Demitryk/Voron2.4-Mods/README.md

# Voron2.4-Mods
My personal Voron 2.4 Mods
