Demitryk/Voron2.4-Mods/Electronics_Brackets/README.md

# Electronics Brackets #

These are all designed to be used with SSR brackets. They all require heated inserts.
  
Brackets:  
  - Pi with 25mm fan holder
  - Octopus Pro with 40 mm fan holder
  - MKS PWC v3 Bracket
  - Meanwell 24V PS Bracket (to mount across 2 DIN rails) NOTE Spacing may differ from mine.

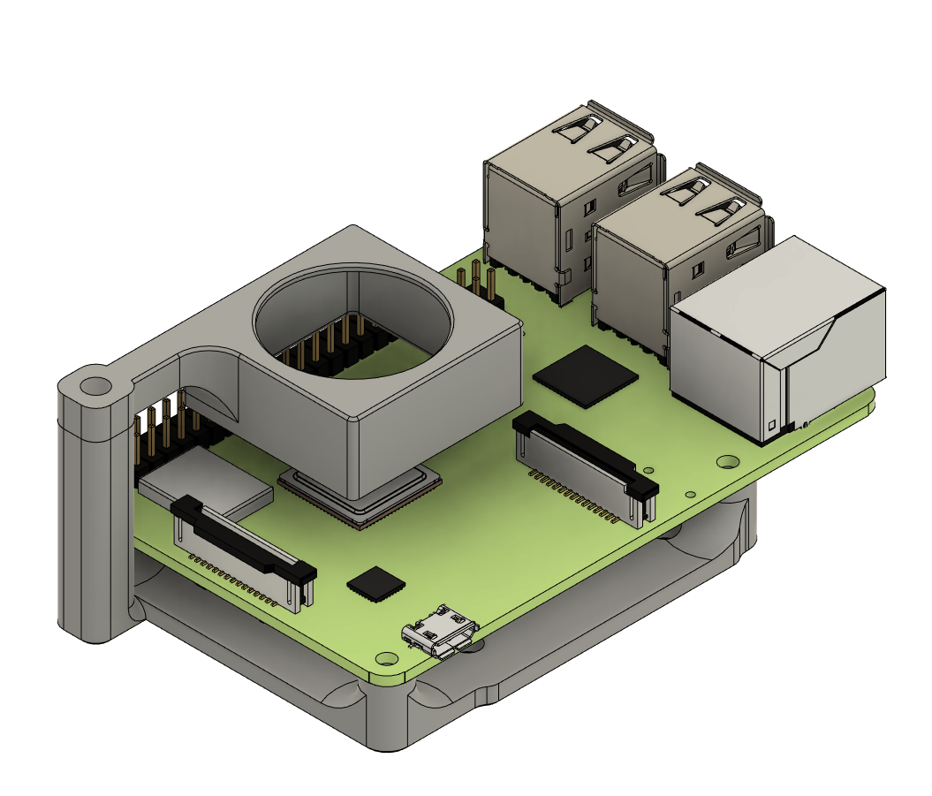
[picture p1: Electronics_Brackets/Images/pi.PNG]
 
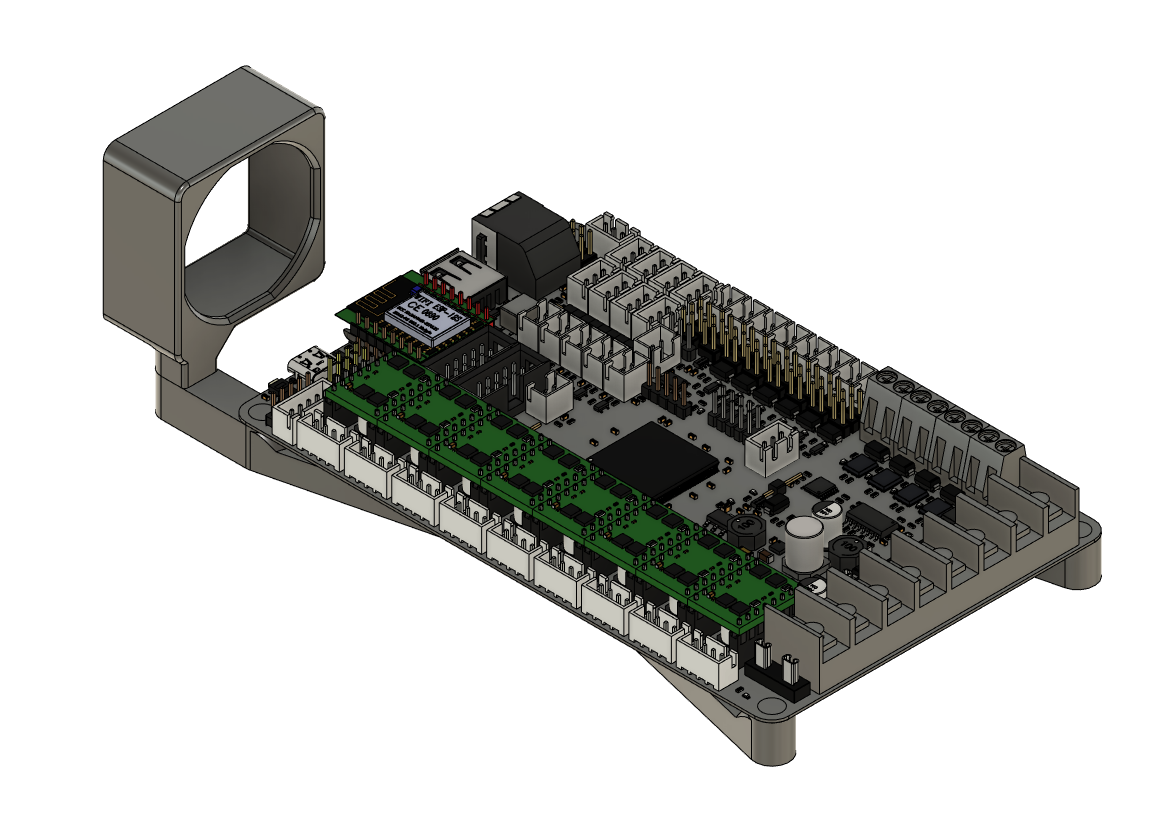
[picture p2: Electronics_Brackets/Images/Octo.PNG]
 
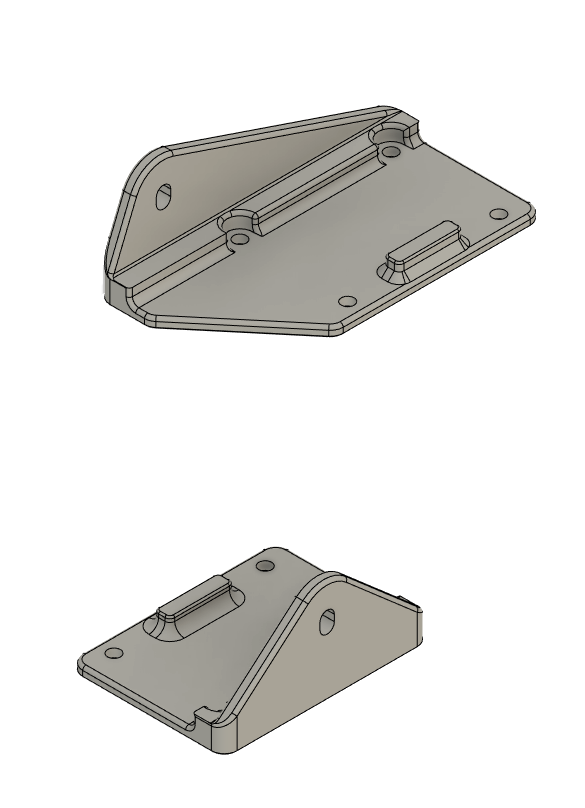
[picture p3: Electronics_Brackets/Images/24V.PNG]
 
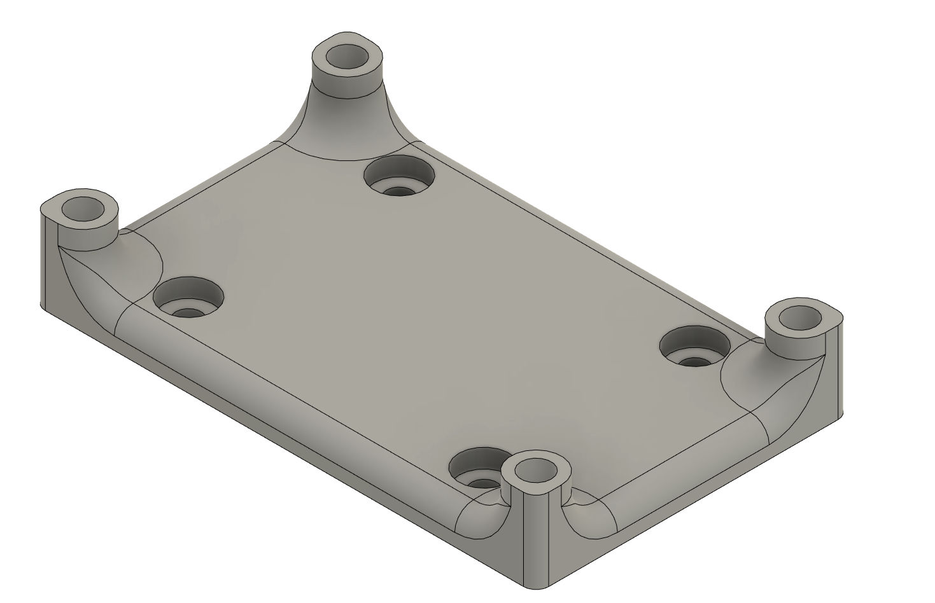
[picture p4: Electronics_Brackets/Images/PWC.PNG]
