Demitryk/Voron2.4-Mods/Bed_Frame_Backlit_Logo/README.md

# Bed Frame Backlit Logo #  

Another Backlit detail for the Voron. This will fit as shown if your bed supports are the distance directed in the BOM (130mm).

### What You Need ###  
---Printed Pieces  
- Main Body x1 - Any Color  
- Clear Body x1 - Clear  
- O Center x2 - Any Color  
- R Center x1 - Any Color  
- Lid x1 - Any Color  

---Hardware  
- 2 x M3 Threaded Inserts   
- 2 x M3 8mm Socket Screws  
- 2 x M5 8mm Screws
- COB LEDs  
- Super Glue 

Here’s is a link to the ones i used:    
https://www.amazon.com/gp/product/B08M9MSH77/ref=ppx_yo_dt_b_asin_title_o04_s07?ie=UTF8&th=1

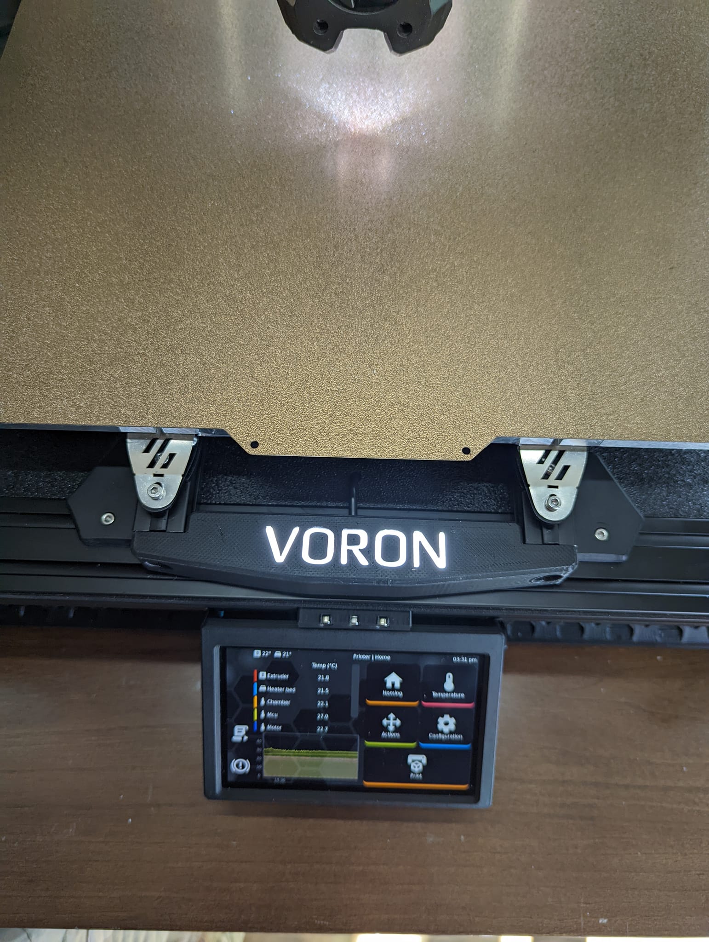
[picture p5: Bed_Frame_Backlit_Logo/Images/actual.jpg]
 
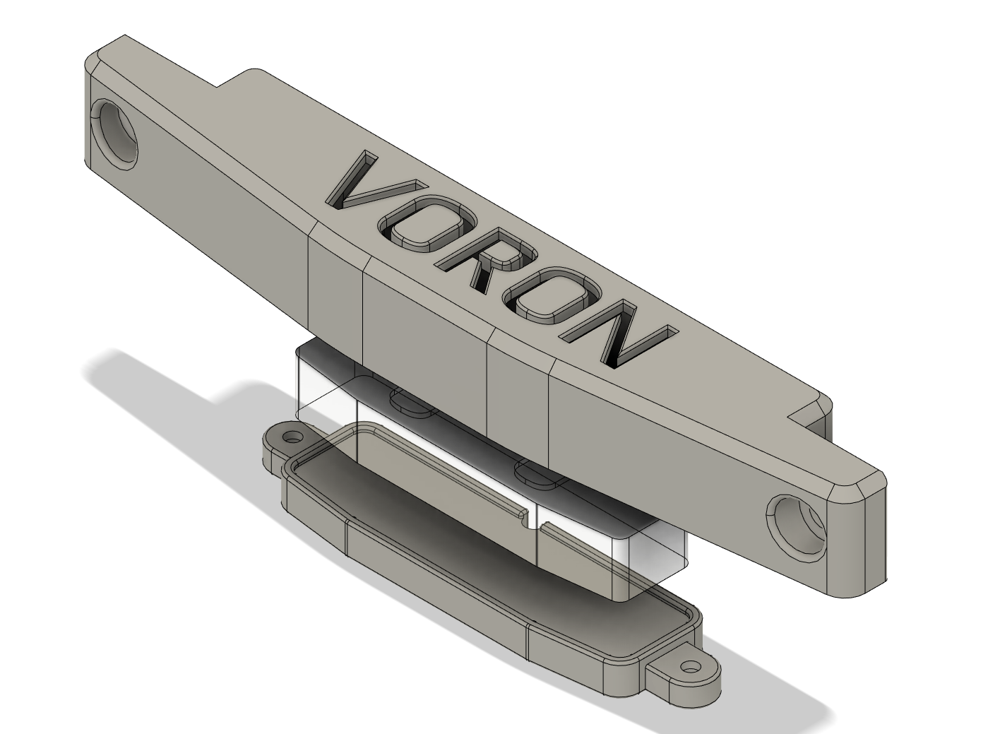
[picture p6: Bed_Frame_Backlit_Logo/Images/Break down.PNG]
 
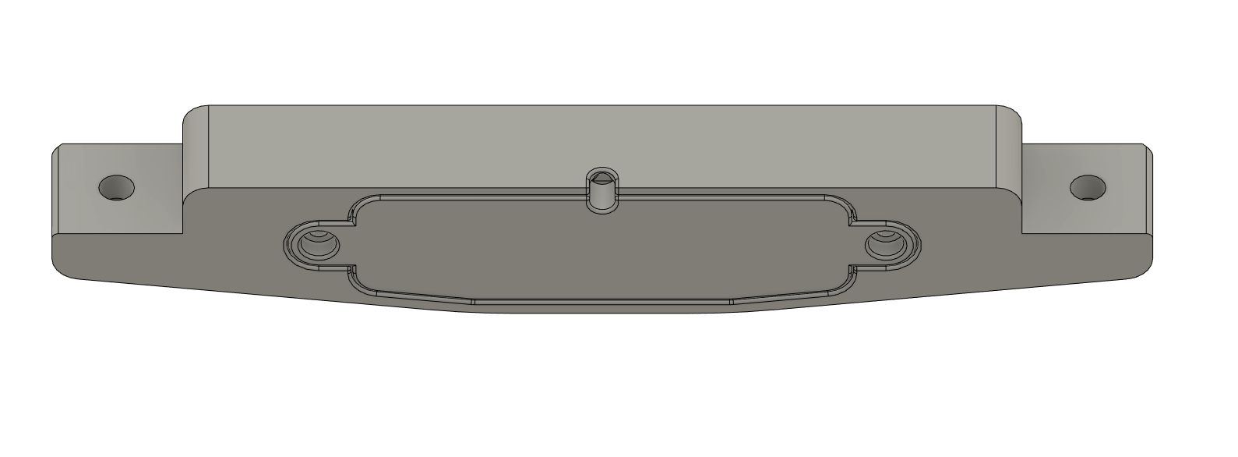
[picture p7: Bed_Frame_Backlit_Logo/Images/Bottom.PNG]
 

___________________________________________________________________________________________________________________________________________
### Installation ###  

---Threaded Inserts and LEDs  
The 2 threaded m3 inserts are placed in the holes in the main body. LEDs should be routed as shown in red. I would solder the wire to the LEDs before routing

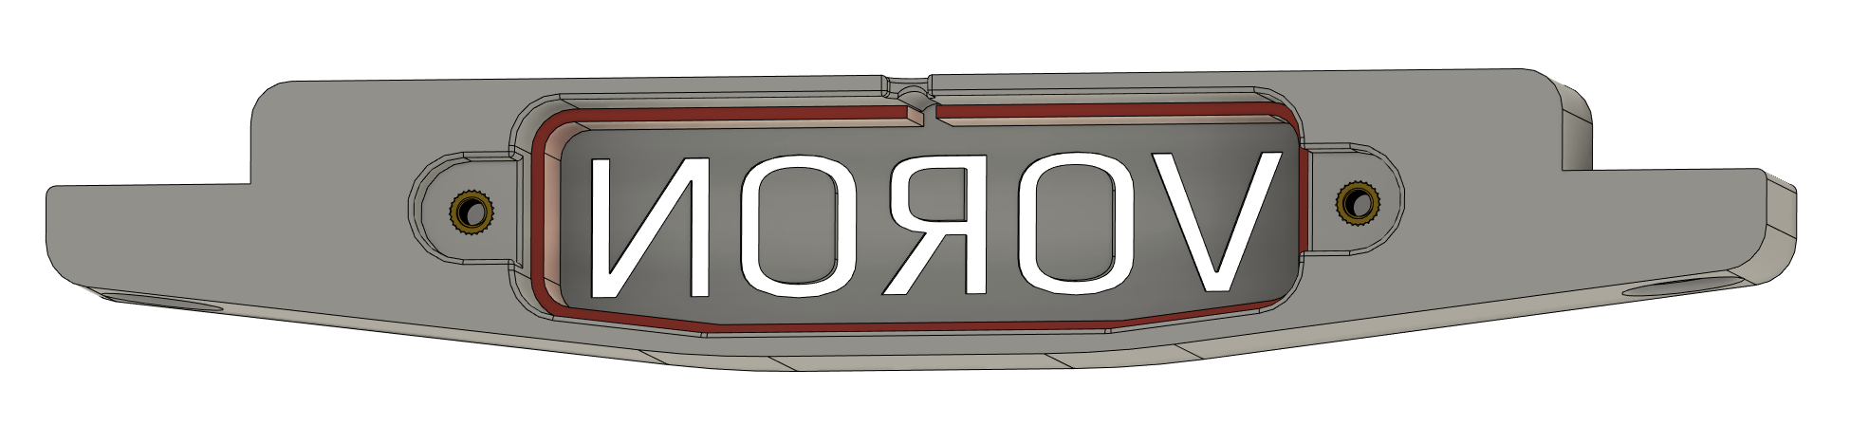
[picture p8: Bed_Frame_Backlit_Logo/Images/LED.PNG]
  

--- Instructions  
- Print pieces   
- Install threaded inserts  
- Install LEDs routing the wire trough the hole  
- Put everything together and install screws
- Glue and center the O and R Centers inplace  
- Install on the frame ends  
- Wire to power source
