Demitryk/Voron2.4-Mods/Backlit_Logo/README.md

# Backlit Voron Logo #  
  
***This logo is 12mm thick. will not fit in on a standard framed Voron back panel ... 4040/4020 frame only***  
  
Another option for the back deck artwork. This requires you to drill 6 holes in the back panel using the drill hole guide.

### What You Need ###  
---Printed Pieces  
- Logo Frame x1 - Any Color  
- Logo Middle x1 - Clear  
- Logo Side x2 - Clear  
- Outer Ring x1 - Clear  
  
for clear printed pieces I used a honeycomb infill with 4 top layers to obtain that hexagon effect. i printed them top side down so they were smooth because when using so little infill the tops arent as pretty. I used sunlu clear petg.   

---Hardware  
- 5 x M3 Threaded Inserts   
- 5 x M3 8mm Socket Screws  
- Foam tape
- COB LEDs   
  
NOTE: LEDs strips cannot be more that 9mm tall or 2mm thick. I designed this to be used with COB LEDs.  These give a continuous strip of light. They do come in 12V, 24V, and 5V addressable RGB. i used 6000K white.

Here’s is a link to the ones i used, they say they are 10 mm tall but were actually 8mm:   
https://www.amazon.com/gp/product/B08M9MSH77/ref=ppx_yo_dt_b_asin_title_o04_s07?ie=UTF8&th=1

 
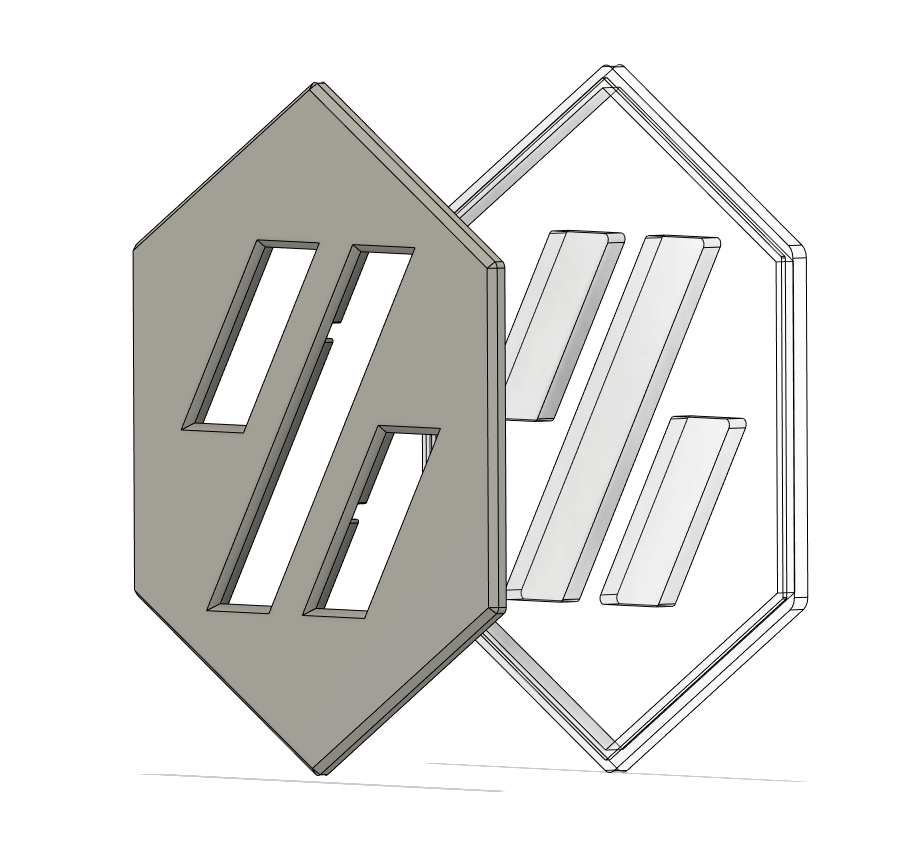
[picture p19: Backlit_Logo/Images/Exploded.PNG]
 
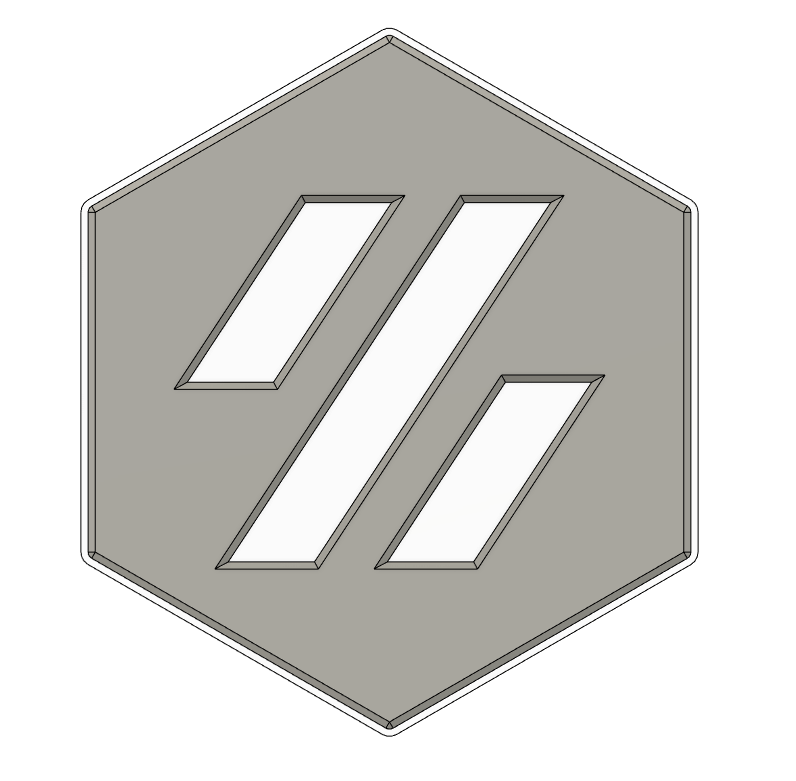
[picture p20: Backlit_Logo/Images/Front.PNG]
 
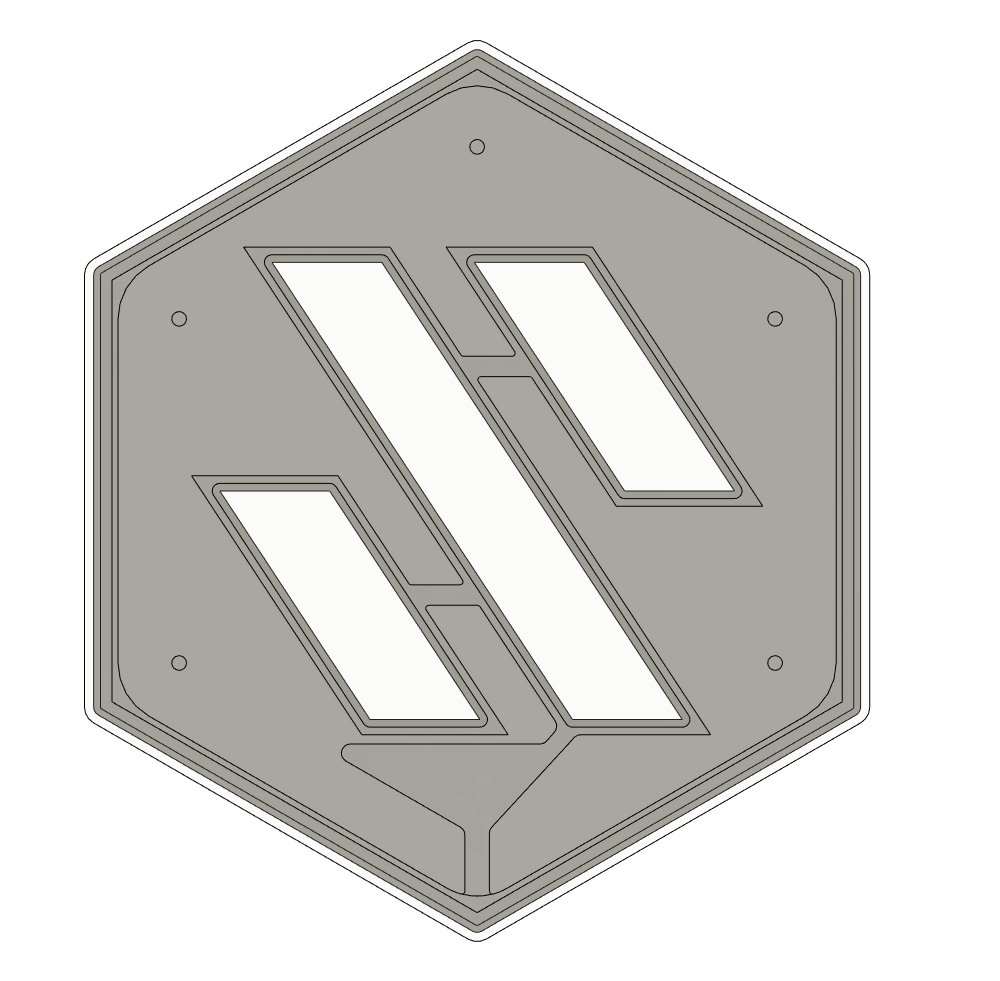
[picture p21: Backlit_Logo/Images/Rear.PNG]
 
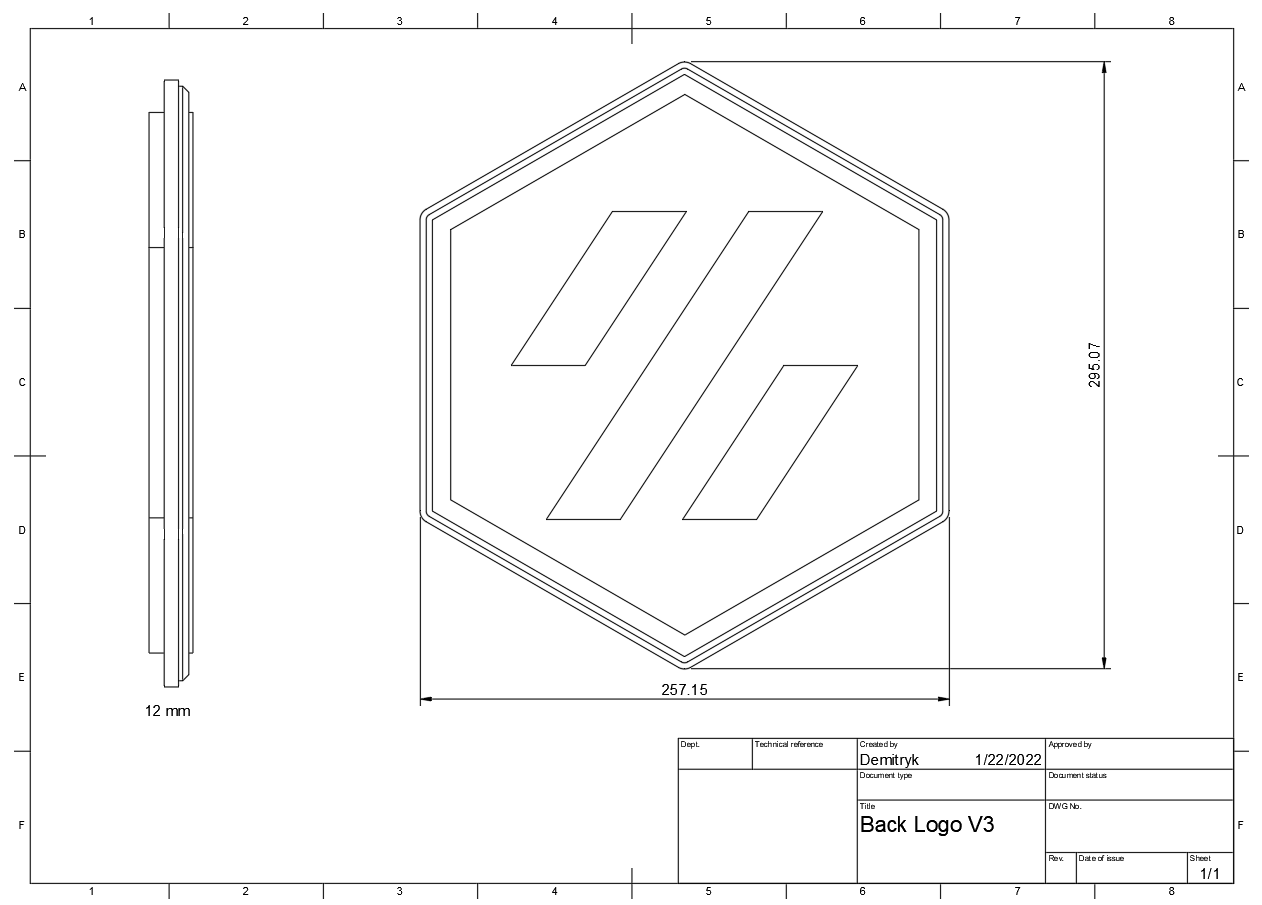
[picture p22: Backlit_Logo/Images/Size.PNG]
 

___________________________________________________________________________________________________________________________________________
### Installation ###  

---Threaded Inserts and LEDs  
The 5 threaded m3 inserts are placed as shown. LEDs should be routed as shown in red. I would solder the wire to the LEDs before routing 

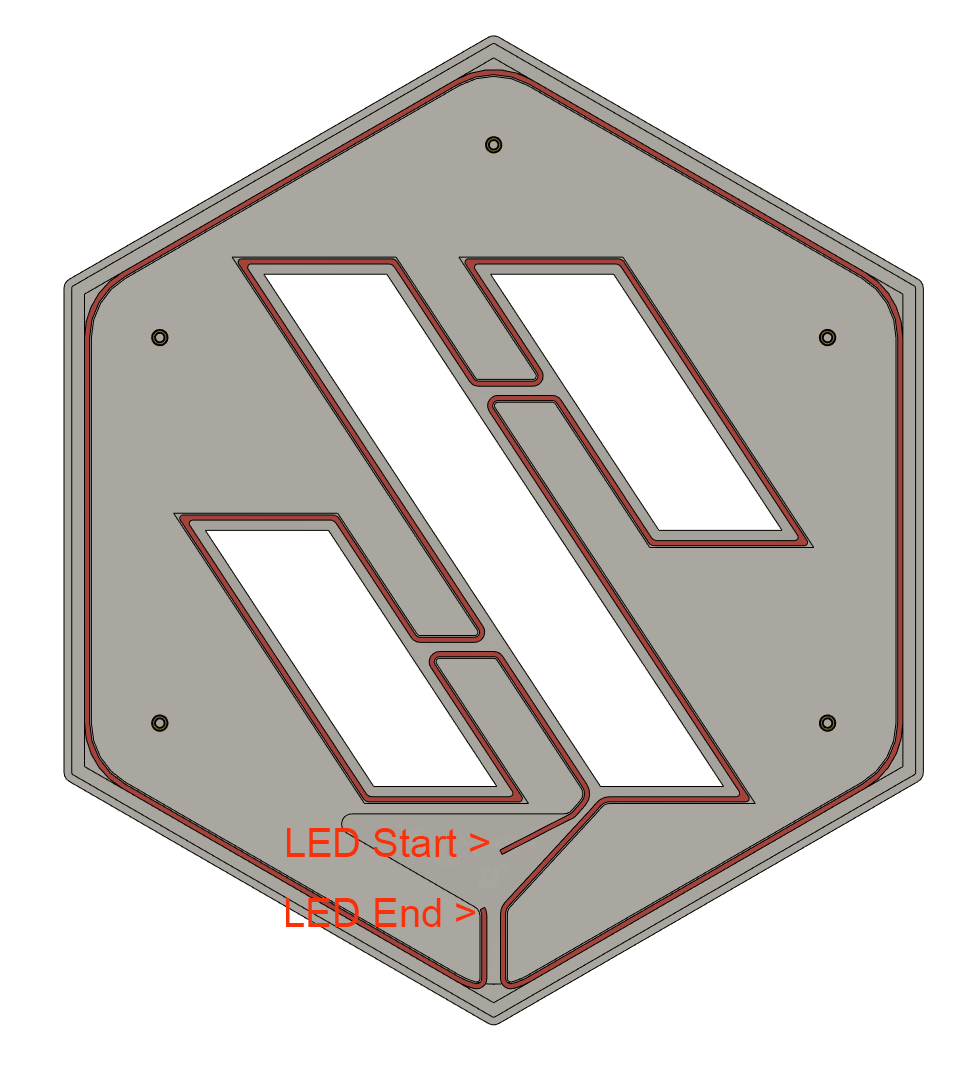
[picture p23: Backlit_Logo/Images/Install.PNG]
  

--- Instructions  
- Print pieces   
- Install threaded inserts  
- Install LEDs  
- Center the drill hole guide on the back panel and drill the 6 holes. The bottom hole is to route the wire though the back.  
- Place foam tape on the back side of the outer ring and on the back side of the logo pieces. this will force them to be squished and keep pieces from rattling  
- install the screws, they should go through the back panel into the Logo frame
