Demitryk/Voron2.4-Mods/BTT_PiTFT5_Screen_Mount/README.md

# BTT PiTFT5 v2 Screen Mount  #
This is a screen mount for the BTT PiTFT5 v2. It is a fixed angle and has a bezel to cover the edges of the screen. The bezel still allows access to the black light wheel and the inversion switch. You have two options in frame mounts.

### What You Need ###  
----printed pieces  
- Bezel.stl  
- Back.stl  
- Sttts frame Mount.stl (30 degree angle) or Table Clearence Frame Mount.stl (52 degree angle) 

*NOTE: I did not create the Sttts frame mount, this was designed by sttts. here is the link to the original Frame mount. https://github.com/VoronDesign/VoronUsers/blob/master/printer_mods/sttts/Waveshare-5.5-inch-HDMI-AMOLED/STLs/Voron-2.4-Mount-Generisch-v6.stl* 

----Hardware  
- Big Tree Tech PiTFT5 v5 and the screws it came with  
- Longer 15 pin Display Cable  
- 6 x M3 Threaded Inserts  
- 2 x M3 Flat Head Countersunk Screws  
- 4 x M3 6mm Socket Screws  
- 3 x M3 10mm Socket Screws  
- 3 x M3 Frame Nuts  

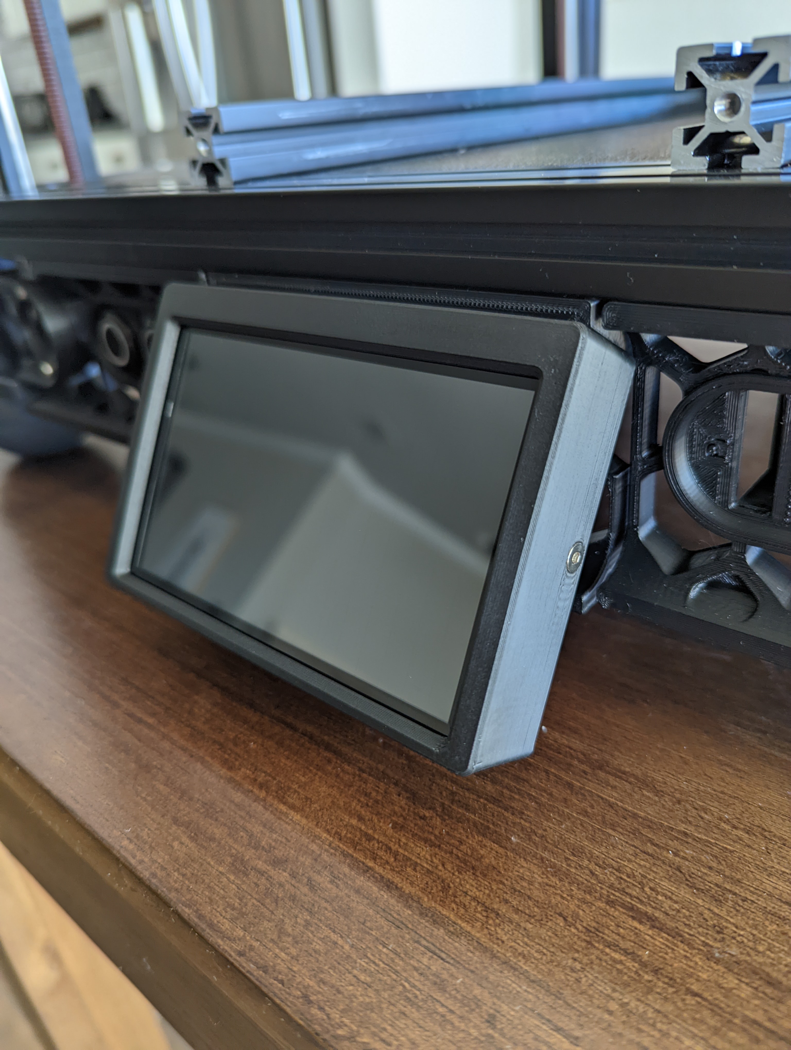
[picture p24: BTT_PiTFT5_Screen_Mount/Images/Actual.jpg]
 
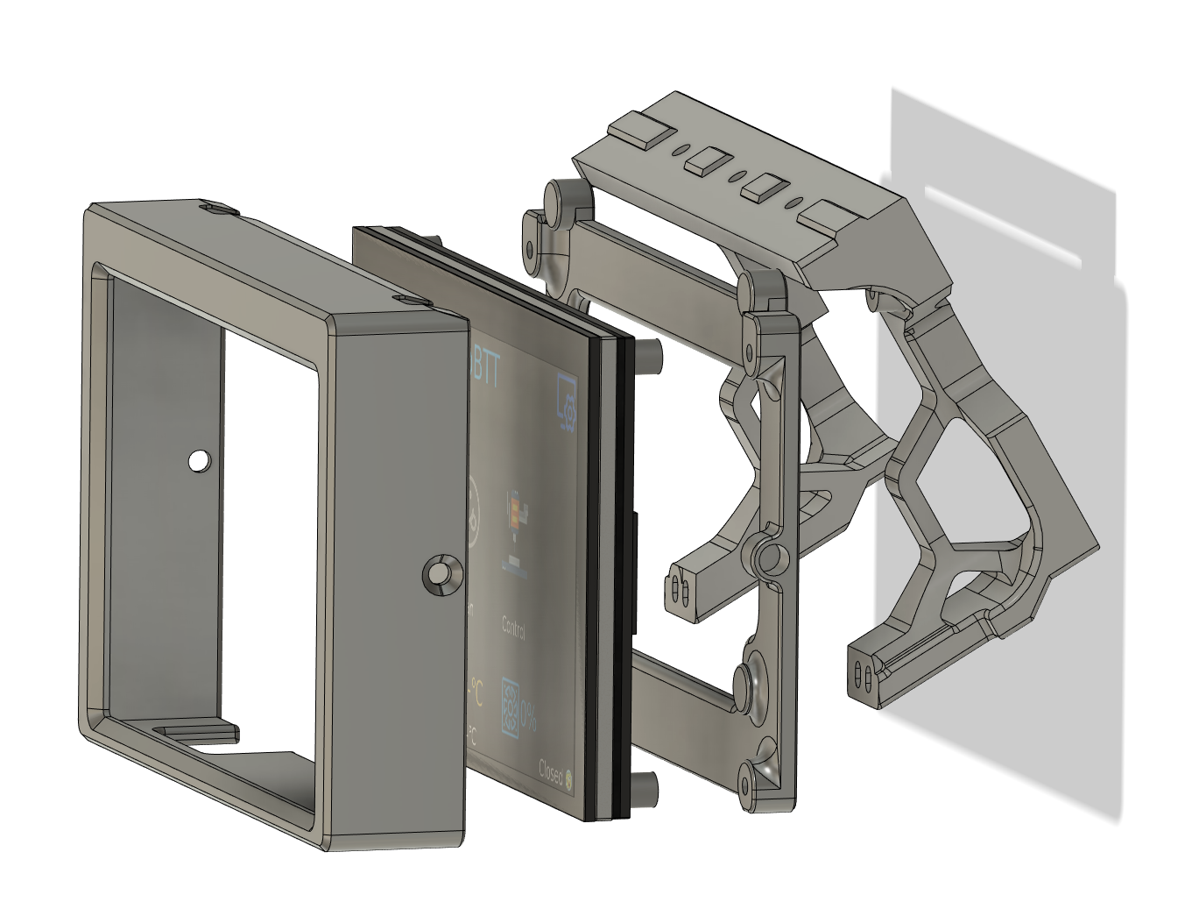
[picture p25: BTT_PiTFT5_Screen_Mount/Images/Exploded.PNG]
 
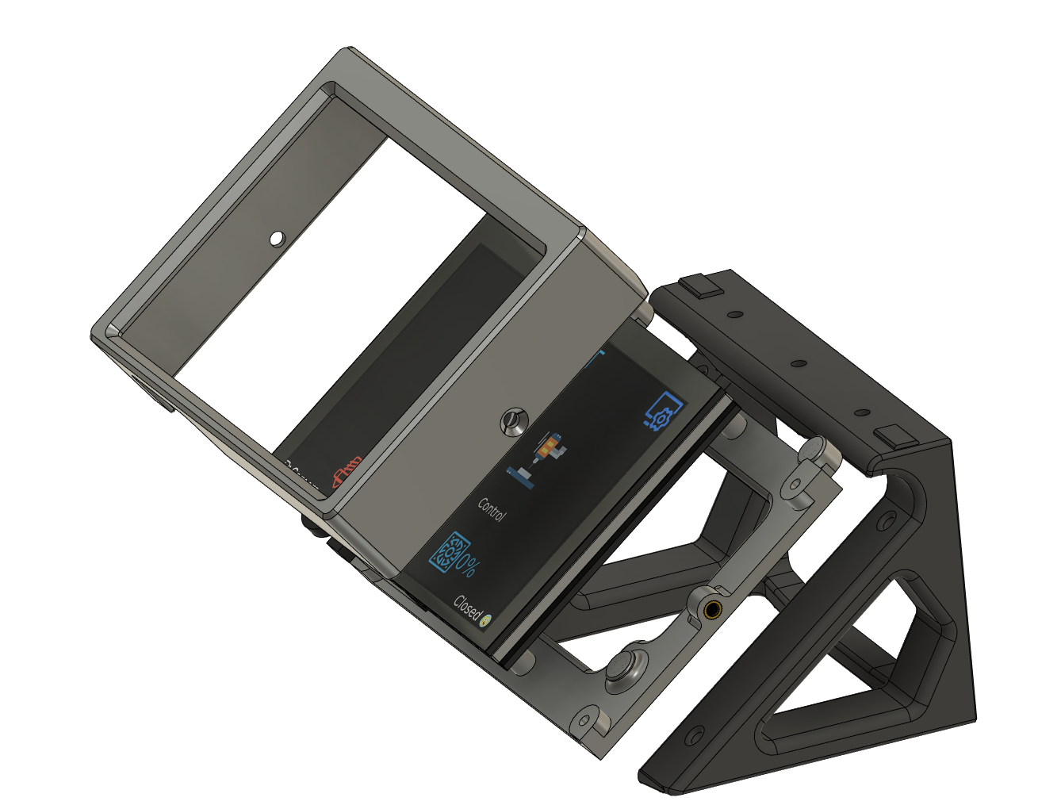
[picture p26: BTT_PiTFT5_Screen_Mount/Images/Explode2.PNG]

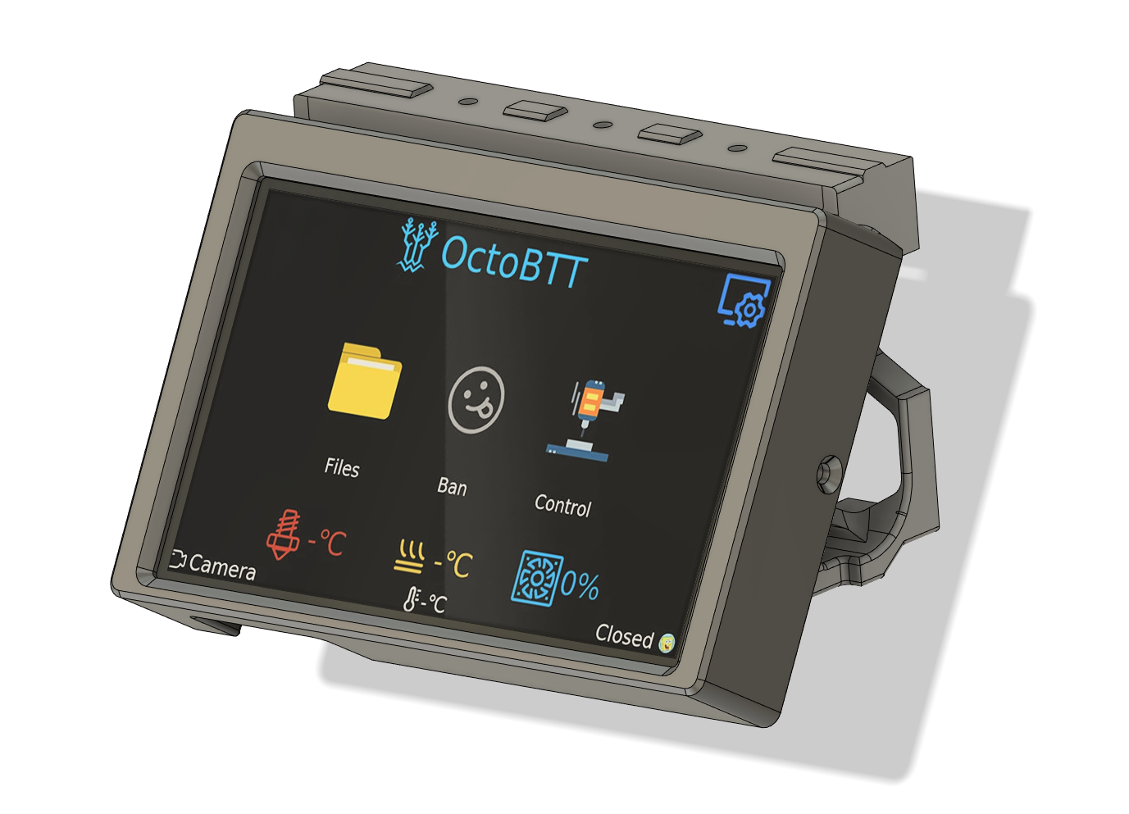
[picture p27: BTT_PiTFT5_Screen_Mount/Images/Angl.PNG]

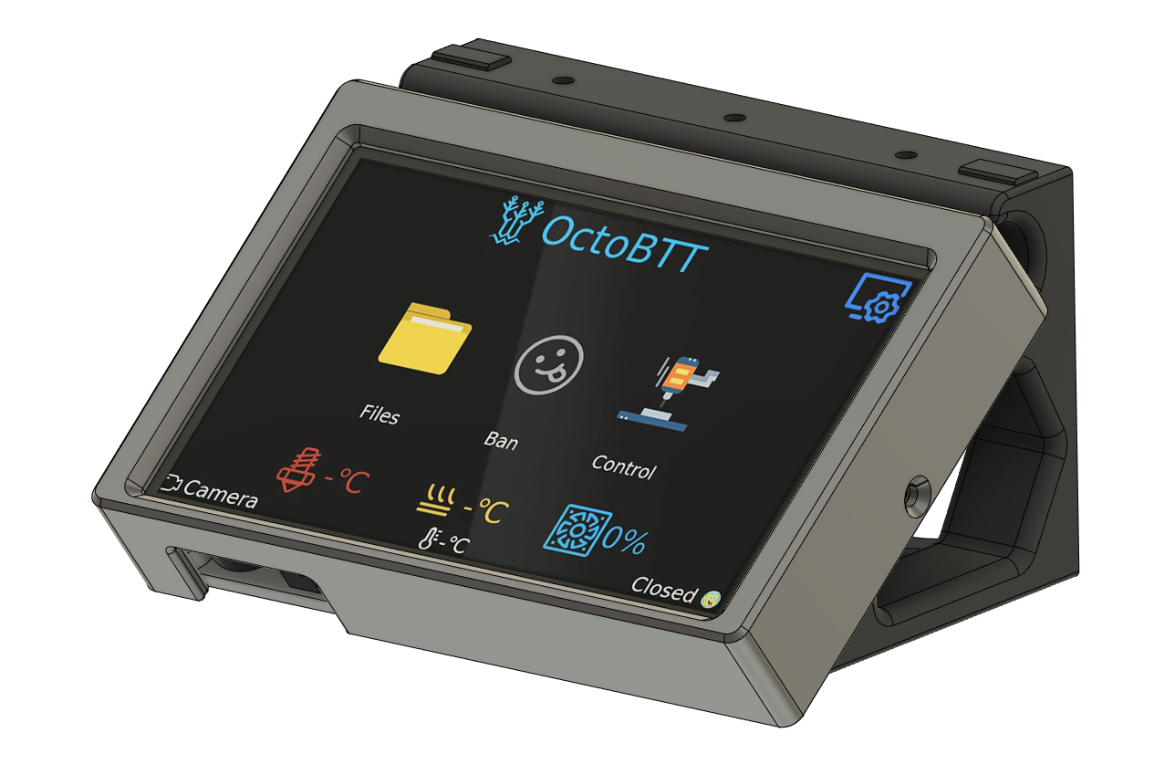
[picture p28: BTT_PiTFT5_Screen_Mount/Images/Angle2.PNG]
 
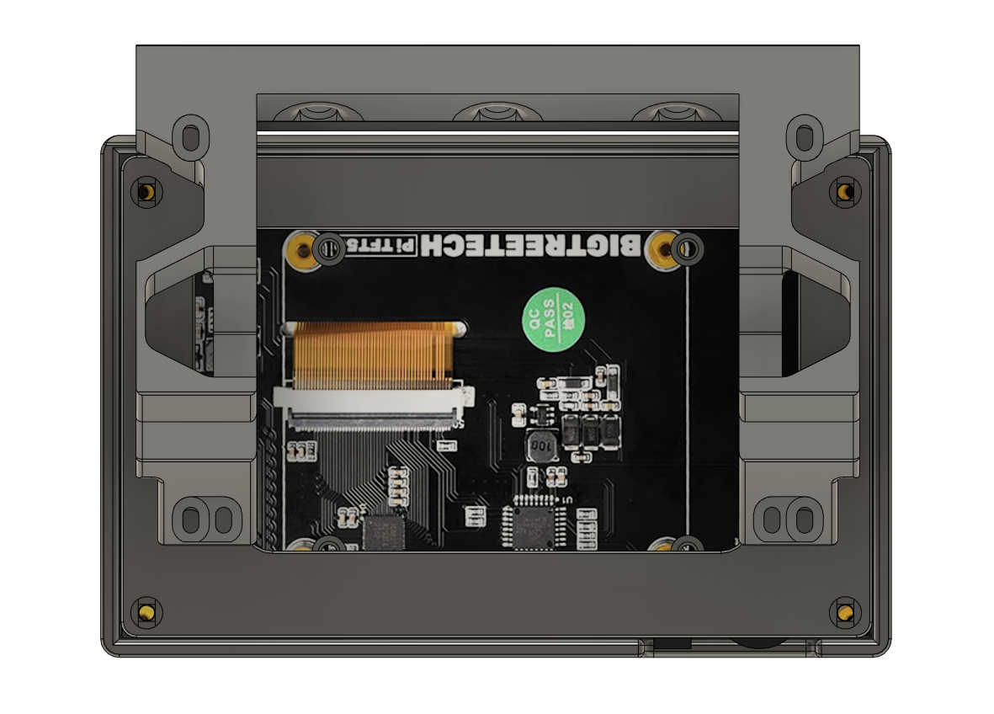
[picture p29: BTT_PiTFT5_Screen_Mount/Images/Bottom.PNG]
 
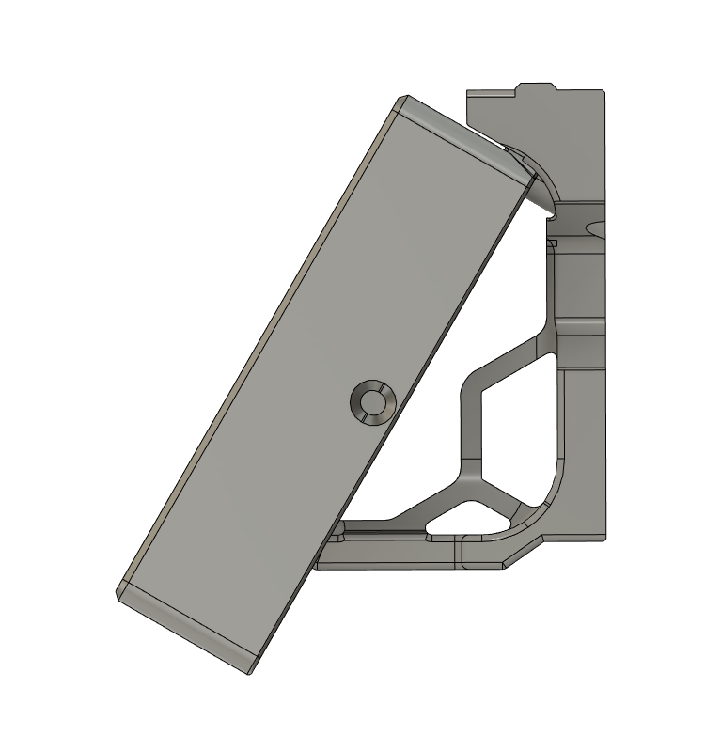
[picture p30: BTT_PiTFT5_Screen_Mount/Images/Side.PNG]
 
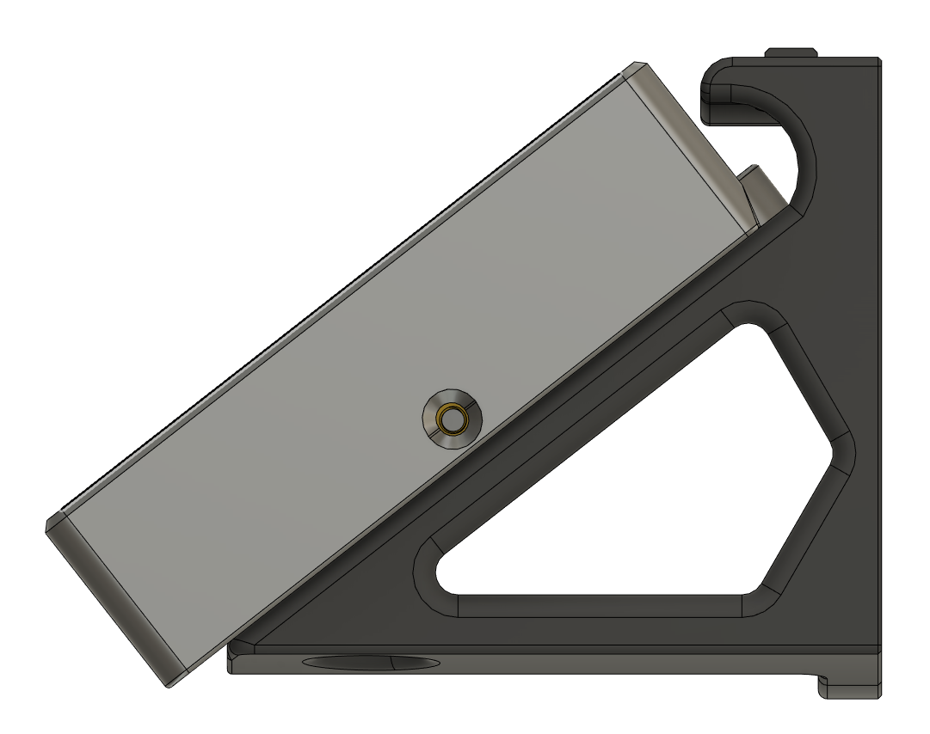
[picture p31: BTT_PiTFT5_Screen_Mount/Images/Side2.PNG]
 

___________________________________________________________________________________________________________________________________________
### Installation ###  

---Threaded Inserts  
The six threaded m3 inserts are placed as shown. There is one more on the other side.  

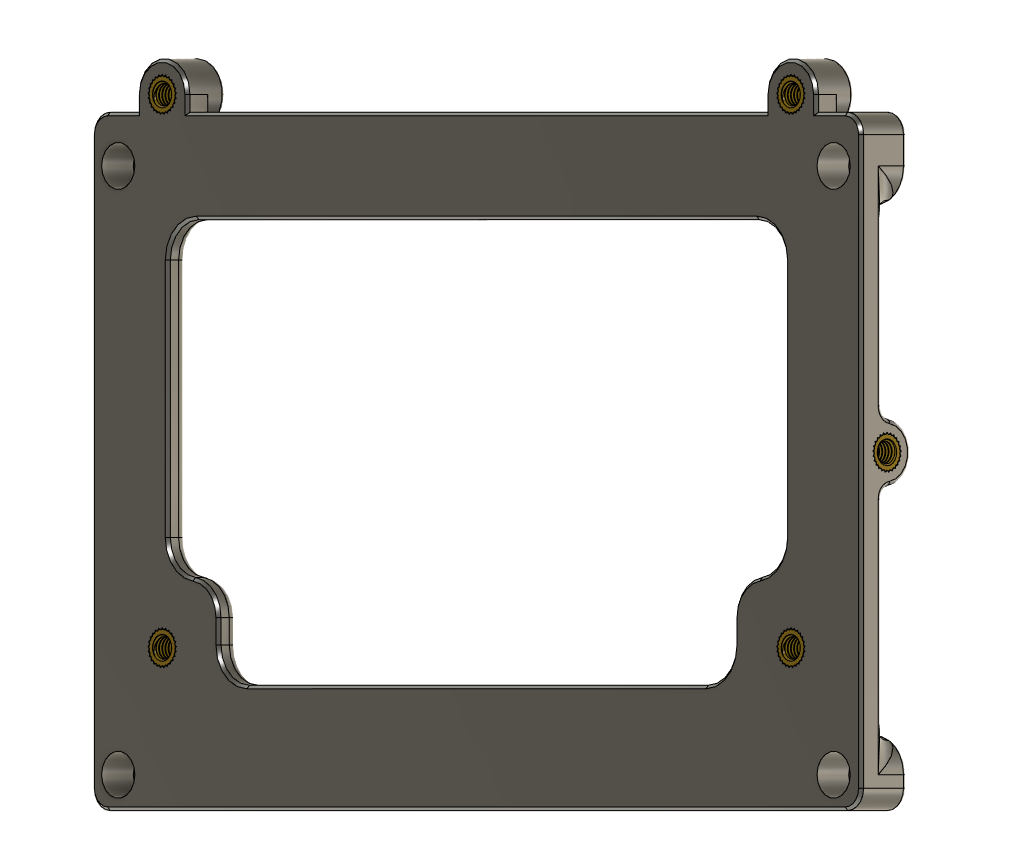
[picture p32: BTT_PiTFT5_Screen_Mount/Images/Threded.PNG]
  

--- Instructions  
- Install display cable to the screen (may have to put a 90 bend in the cable end)
- Use 4 of the screws that came with the screen to attach the screen to the back stl. The back light wheel and switch to be toward the bottom  
- Route the cable behind the screen and though the opening in the back  
- Attach the back stl to the frame mount using the 4 M3 6mm screws  
- Attach the frame mount to the frame using the 3 M3 10mm screws and frame nuts  
- Install the bezel over the screen and secure using the 2 M3 Flat Head Countersunk Screws
