Demitryk/Voron2.4-Mods/Z_Belt_Cover_&_Deck_Clamps/README.md

# Z Belt Cover & Deck Clamps  #  
  
***These will not fit in on a standard framed Voron ... 4040/4020 frame only***  
  
These are just some Z Belt covers and Deck claps I created. The Z belt clamps have a groove that allow you to pass wires from the adjacent vertical V slot to the electronics compartment.

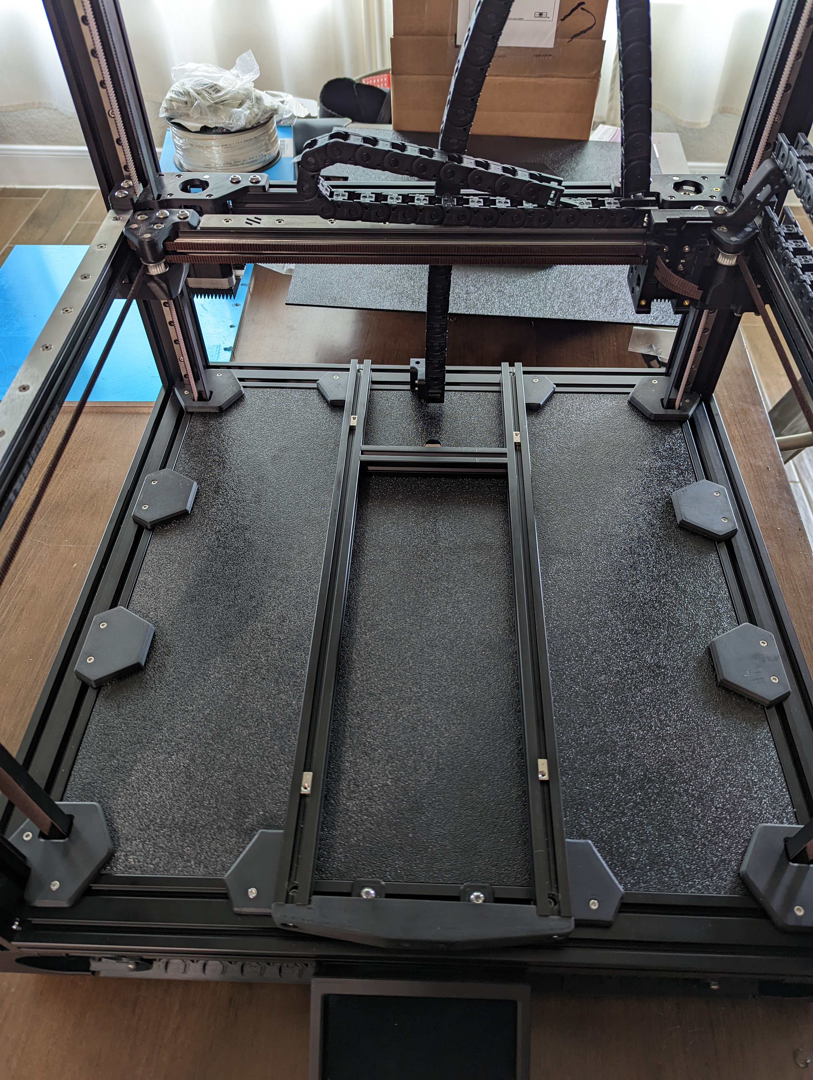
[picture p33: Z_Belt_Cover_&_Deck_Clamps/Images/Actual.jpg]
 
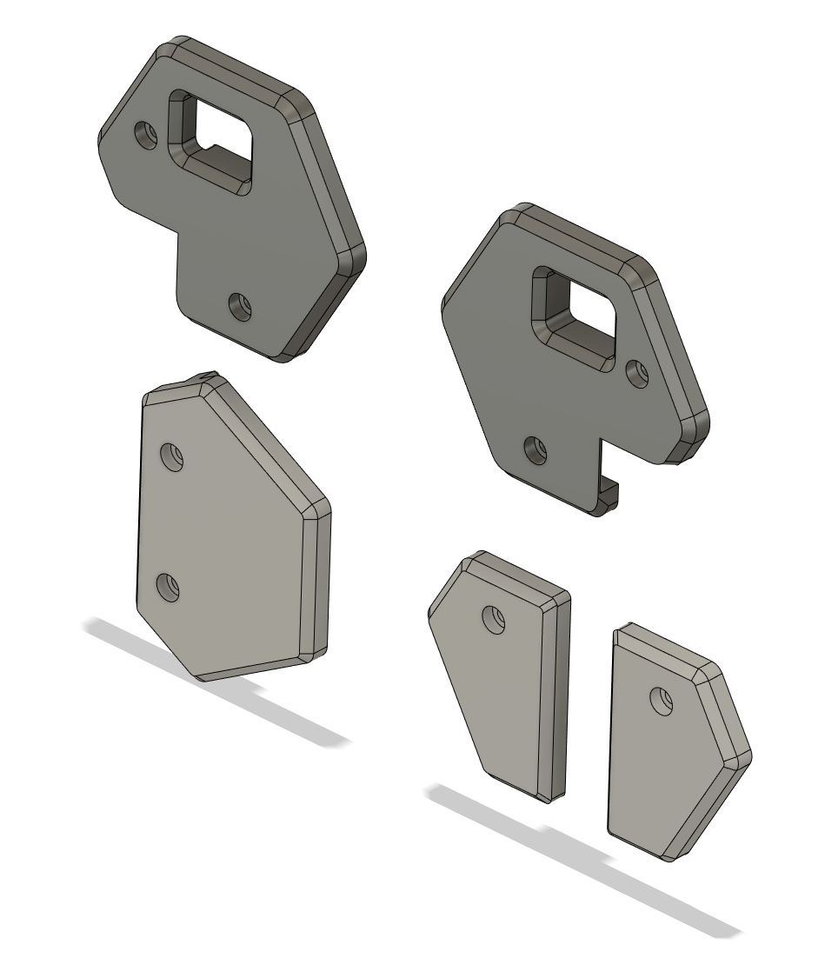
[picture p34: Z_Belt_Cover_&_Deck_Clamps/Images/Angle.PNG]
 
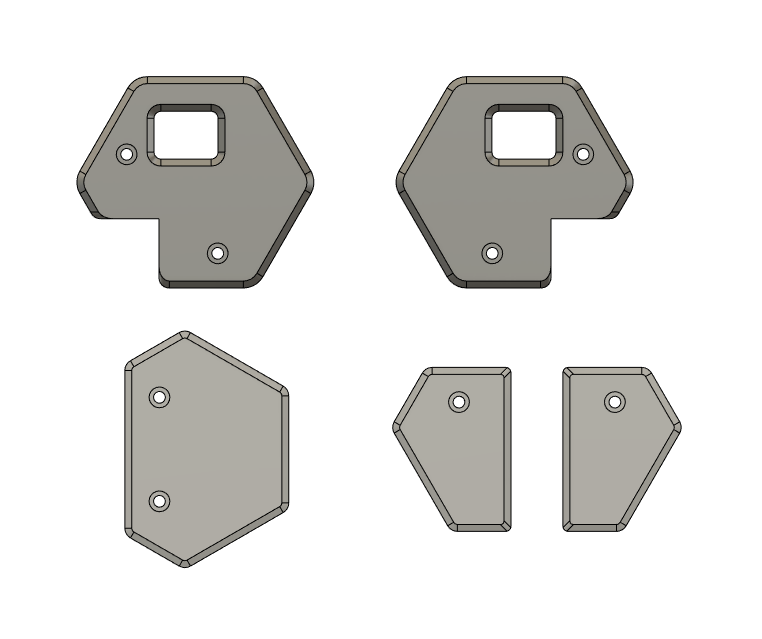
[picture p35: Z_Belt_Cover_&_Deck_Clamps/Images/Front.PNG]
 
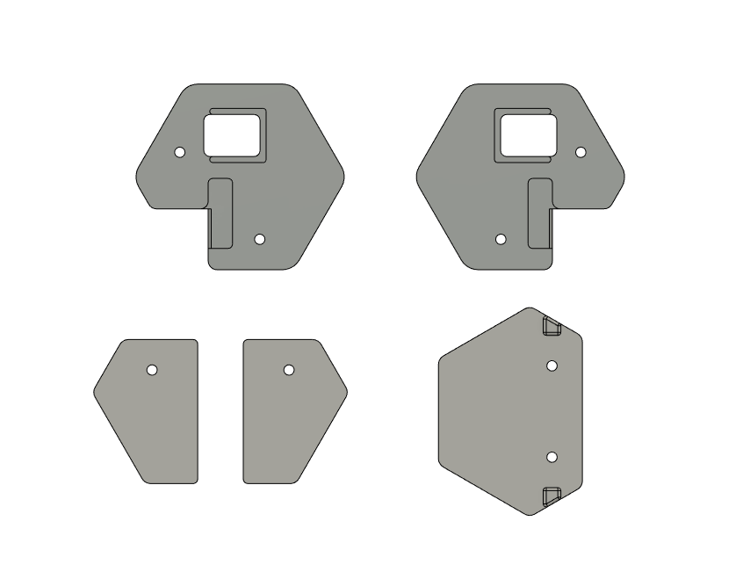
[picture p36: Z_Belt_Cover_&_Deck_Clamps/Images/Rear.PNG]
