Demitryk/Voron2.4-Mods/Skirt_Buttons/README.md

# Skirt Button Mod - For 350mm Version Only  #
These are the front skirts that I modified to install buttons. In the left skirt, there are 3 x 19mm holes that allow the installation of switches. The right skirt contains 2 slots for micro-SD card extenders (for the Pi and control board) and 1 hole of and aviation style connector (16mm). I planned on using the aviation connector for the ADXL345 connection to the Pi. 

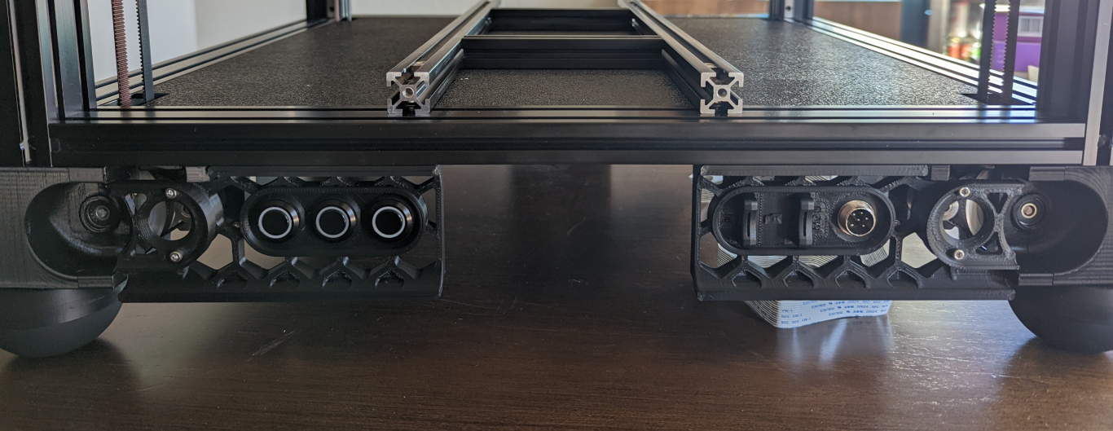
[picture p37: Skirt_Buttons/Images/WithButtons.png]
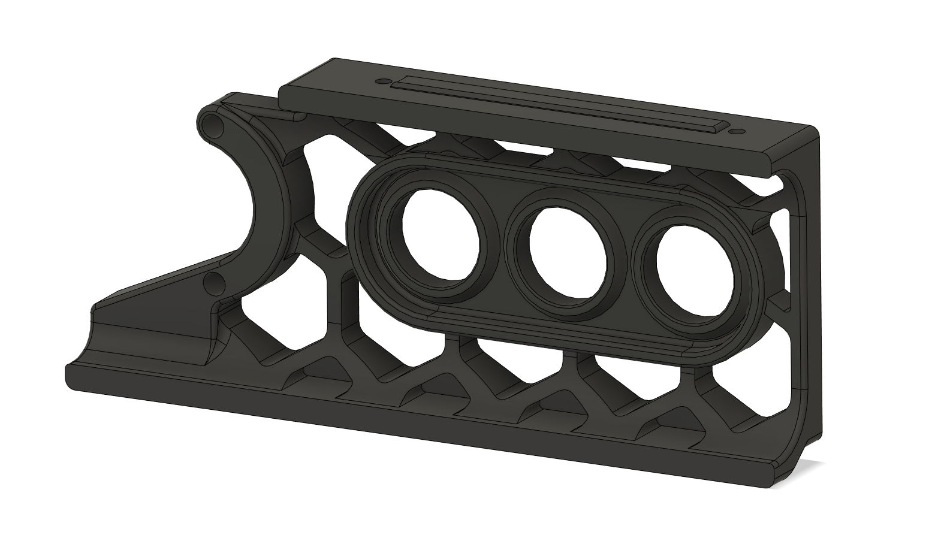
[picture p38: Skirt_Buttons/Images/Left.PNG]
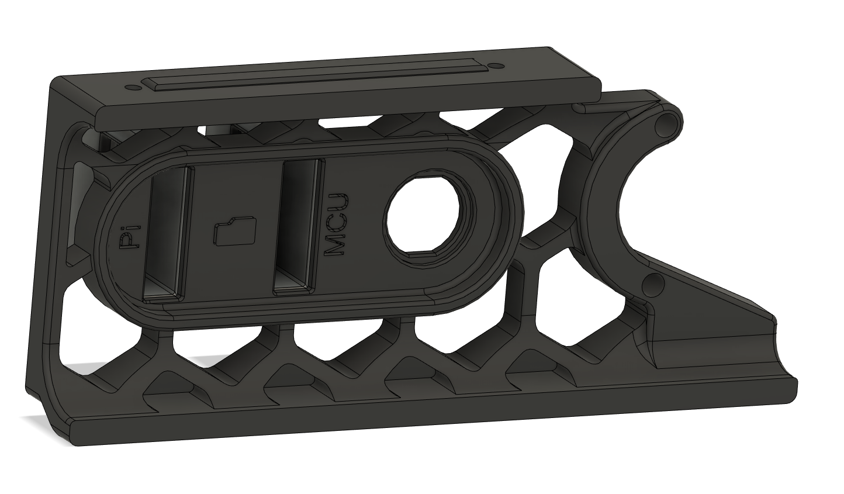
[picture p39: Skirt_Buttons/Images/Right.PNG]
   

___________________________________________________________________________________________________________________________________________
### Installing The SD Slots ###
The two printed SD Slot retainers must be glued into place. i used super glue. The micro-SD extender can be held in place by some VBH tape.

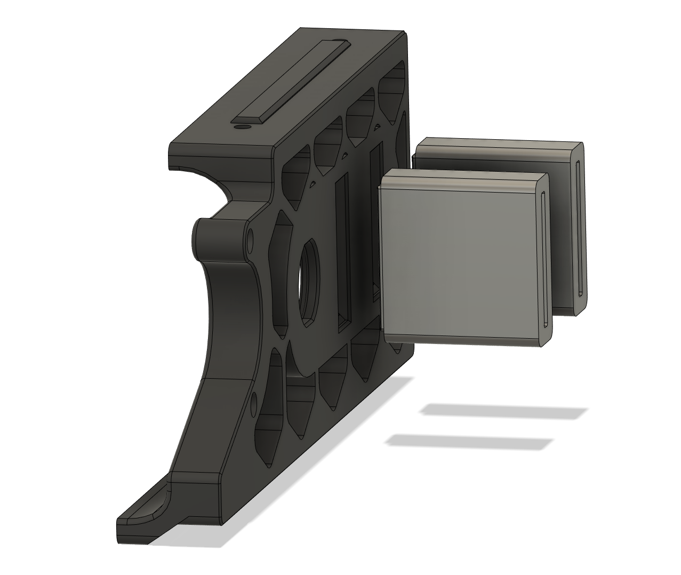
[picture p40: Skirt_Buttons/Images/LeftBack.PNG]


_____________________________________________________________________________________________________________________________________________
### Links to Buttons I used ###

below are links to the particular switches, SD extender, and aviation connector I used. 

Aviation connectors
https://www.amazon.com/gp/product/B07F5FJVHD/ref=ppx_yo_dt_b_search_asin_title?ie=UTF8&psc=1

-----NOTE: This is for a kit that i had on hand, you may be able to find a single connector that you need 

Micro SD extender
https://www.amazon.com/gp/product/B07PY7QCWV/ref=ppx_yo_dt_b_asin_title_o08_s06?ie=UTF8&psc=1

Switches
https://www.amazon.com/Latching-URTONE-Stainless-Mounting-Include/dp/B07N1QRVGS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

-----NOTE: These are not the same switches pictured above but any 19mm round switch can fit here
