Demitryk/Voron2.4-Mods/4040_Feet/README.md

# 4040 FEET #
These Z drive feet are designed for if you replaced the standard 2020 frame with 4040 & 4020 extrusions. I have not changed any position of the Z drive components. I just extended the outer walls of the printed pieces, so they sit flush with the wider extrusions. The screws used are the same as the original BOM.

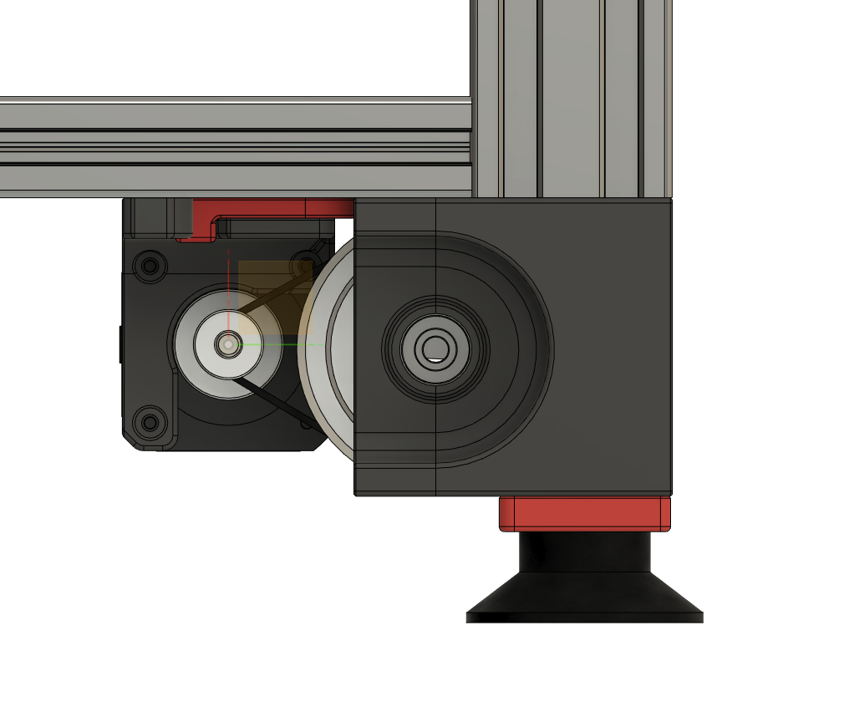
[picture p41: 4040_Feet/Images/Front.PNG]
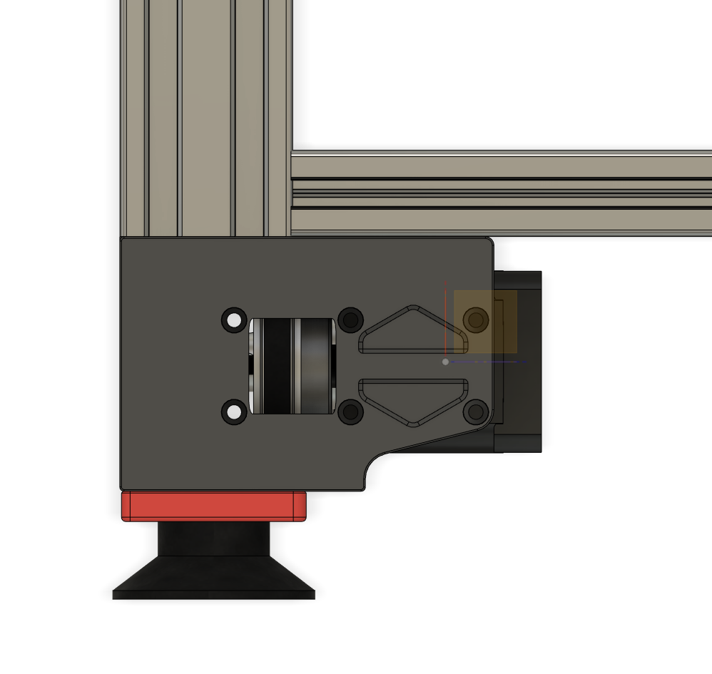
[picture p42: 4040_Feet/Images/Side.PNG]
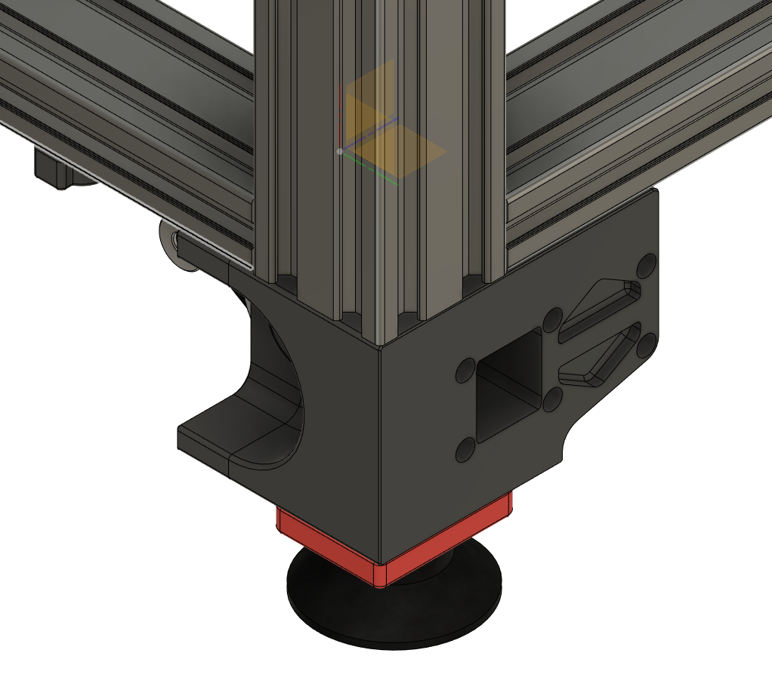
[picture p43: 4040_Feet/Images/Angle.PNG]
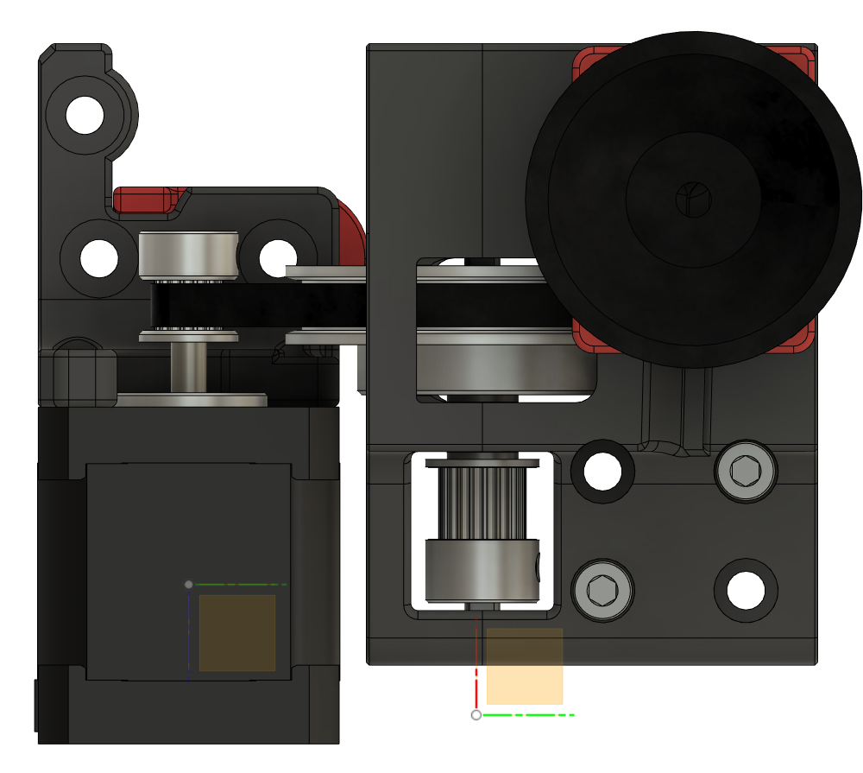
[picture p44: 4040_Feet/Images/Bottom.PNG]
   

### Attaching the Assembly ###
I have added 2 extra screw holes to mount the Z assembly to the extra V-slot in the frame. Using all 4 holes is not necessary, I recommend just using one in each V-slot as show in the image.

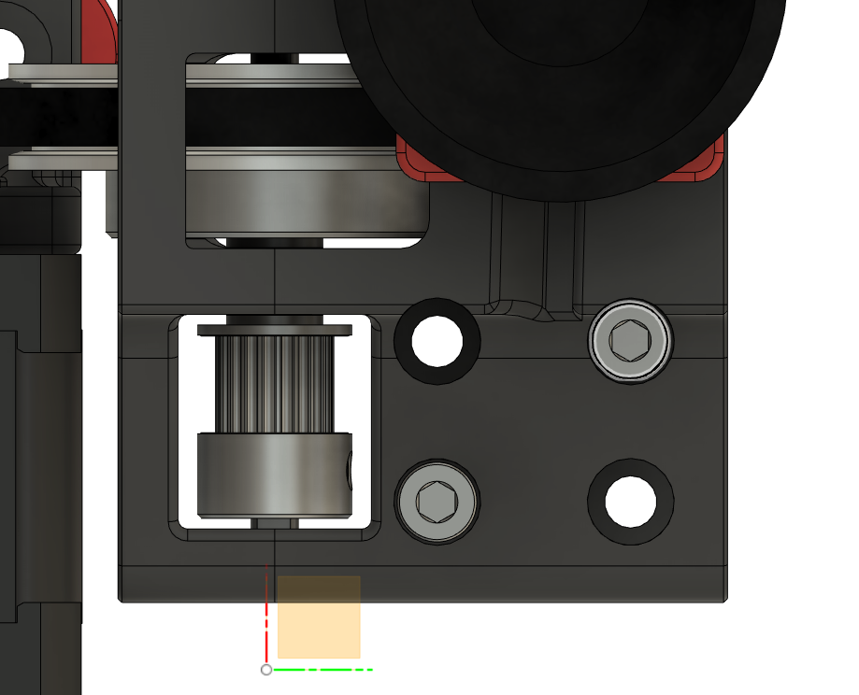
[picture p45: 4040_Feet/Images/Screws.PNG]


### Wire Hole ###
I have added a hold and a grove just in case I decided to put electronics on top of the printer. Wires can be run through the 4040 extrusions, through the hole in the foot and into the electronics compartment.

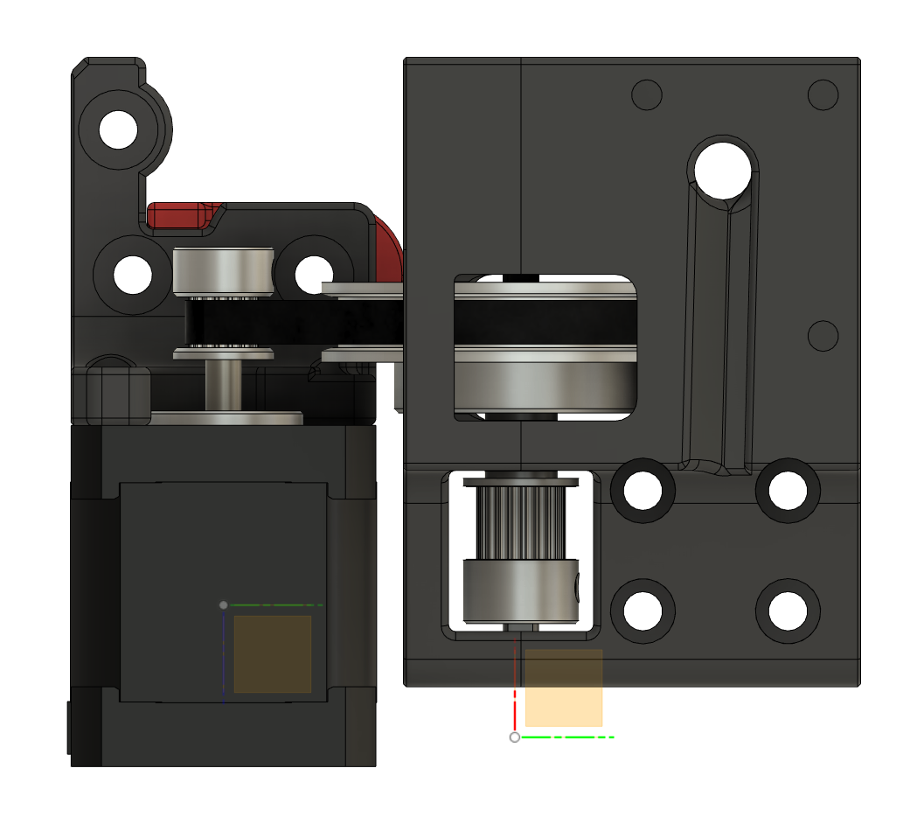
[picture p46: 4040_Feet/Images/Wire Hole.PNG]
