Demitryk/Voron2.4-Mods/BTT_PiTFT5_Screen_Mount/Images/back2.PNG

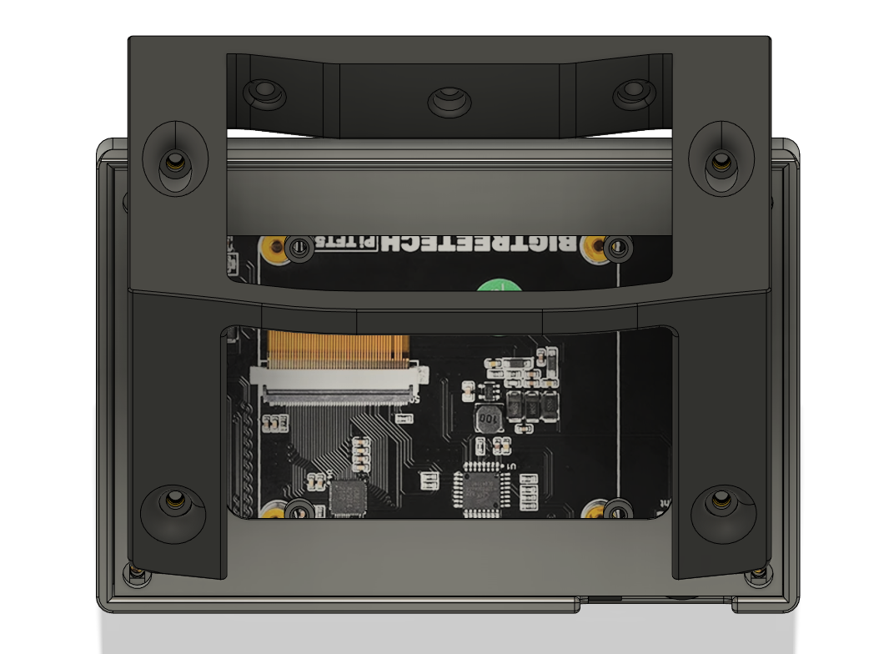
BTT_PiTFT5_Screen_Mount/Images/back2.PNG
