Demitryk/Voron2.4-Mods/BTT_PiTFT5_Screen_Mount/Images/Botton.PNG

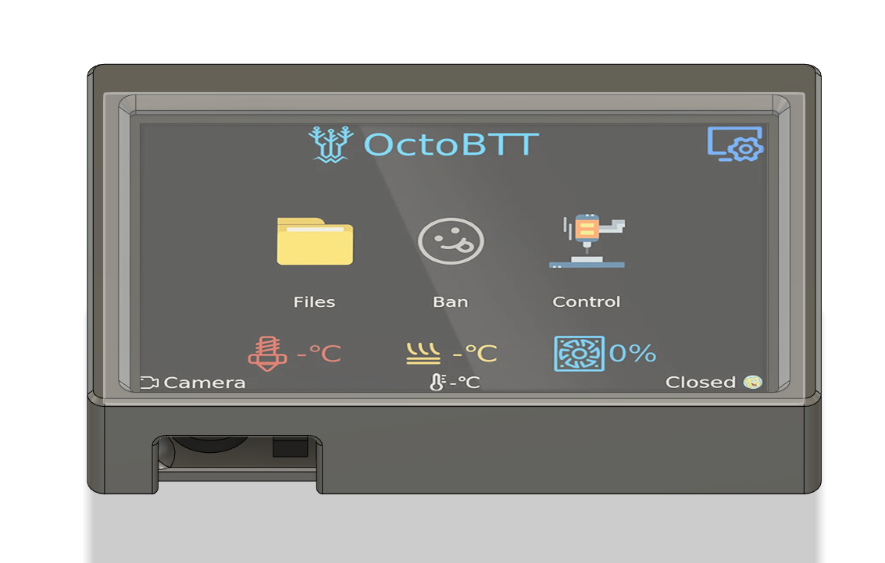
BTT_PiTFT5_Screen_Mount/Images/Botton.PNG
