Demitryk/Voron2.4-Mods/BTT_PiTFT5_Screen_Mount/Images/Front.PNG

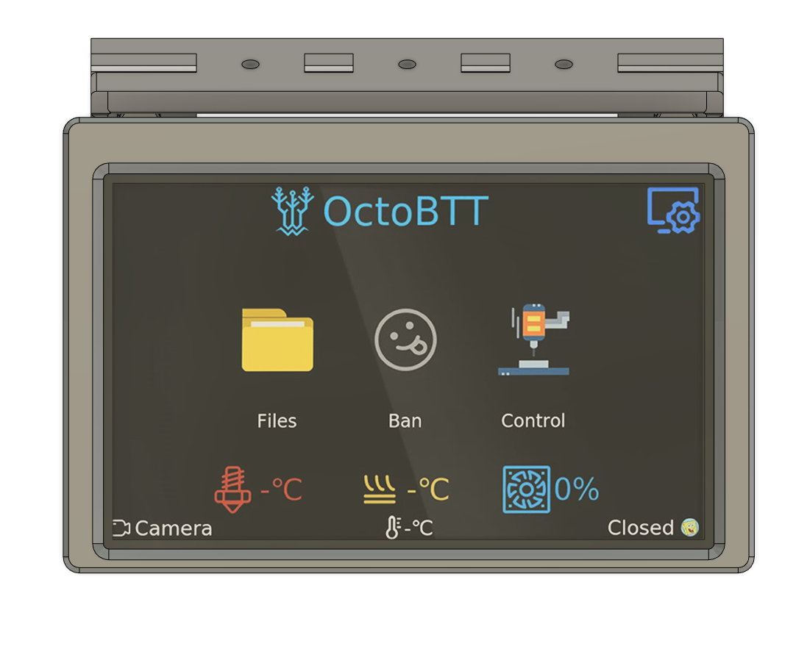
BTT_PiTFT5_Screen_Mount/Images/Front.PNG
