Demitryk/Voron2.4-Mods/LGX_Adapter/Images/Back.PNG

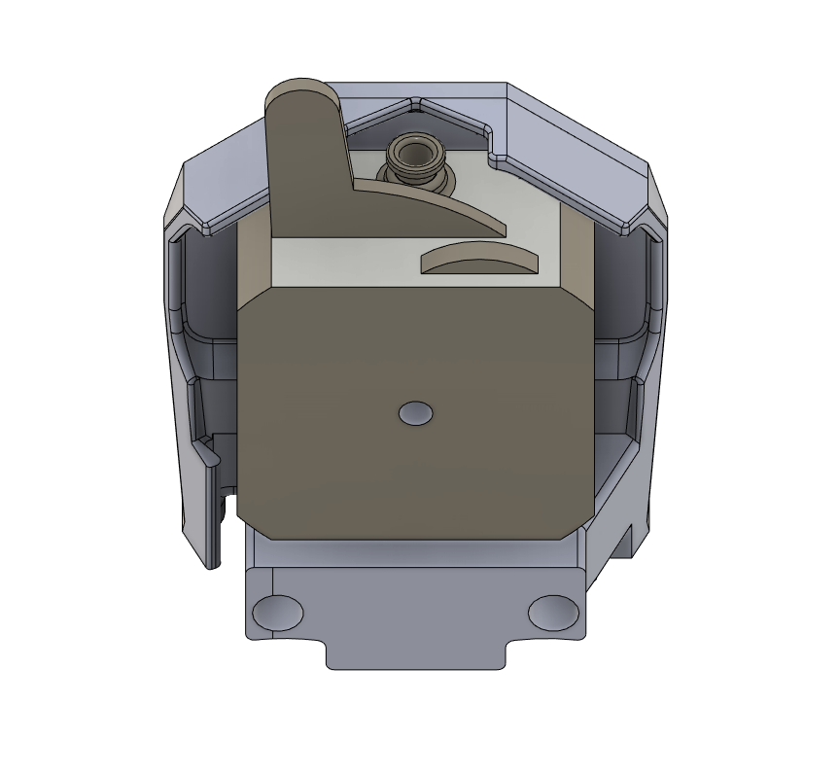
LGX_Adapter/Images/Back.PNG
