Demitryk/Voron2.4-Mods/LGX_Adapter/Images/Full.PNG

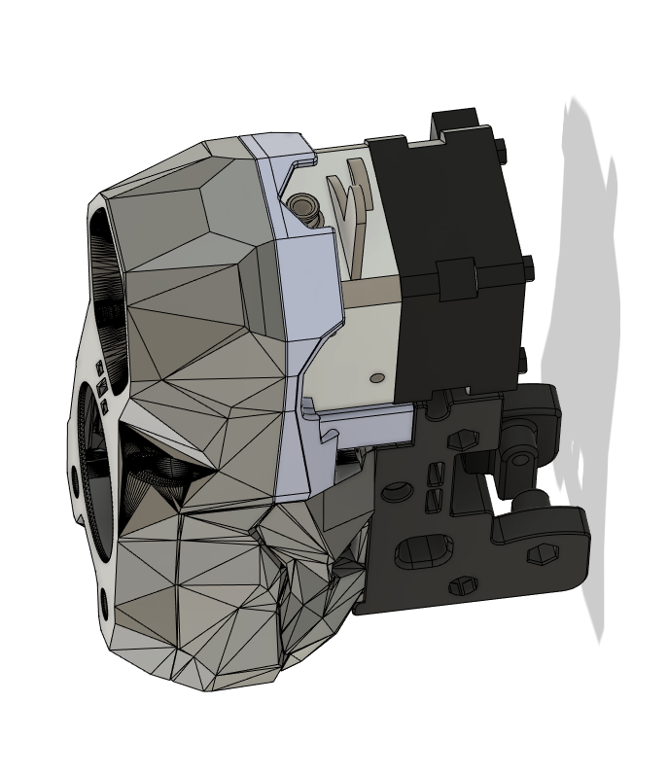
LGX_Adapter/Images/Full.PNG
