Demitryk/Voron2.4-Mods/4040-2040 _Frame_BOM/README.md

# 4040/2020 Frame BOM - 350mm Voron #
This is the BOM I created if you want to use 4040 and 2040 extrusions for your frame. I replaced the four HFSB5-2020-530-LCP-RCP Verticals with 4040s. The original BOM calls for 10 HFSB5-2020-470-TPW, these are intended for the 8 laterals and 2 bed supports. I swapped out the 8 laterals for 2040s and extended the 2 bed supports by 40mm so they can be bind jointed to the frame.   

Using this as your frame does not change any of the positions of the printer components. All printed pieces will be the same (except the feet). However, since the skirts are shifted out 20mm because of the new wider frame, the bottom cover that comes in the standard pannel kits will be too small. The rest of the pannels fit the same.  

There are feet I created to fit this frame and they can be found here  
https://github.com/Demitryk/Voron2.4-Mods/tree/main/4040_Feet
