Demitryk/Voron2.4-Mods/4040_Feet/STLs/z_drive_main_b_x2.stl

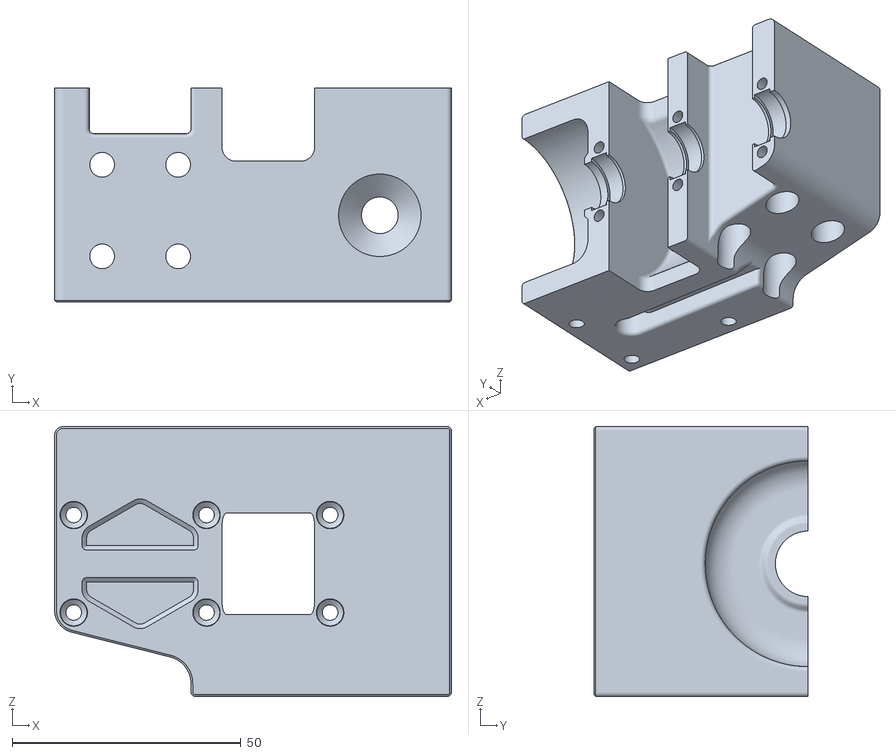
[picture p52: CAD file, 2022-01-14]
4040_Feet/STLs/z_drive_main_b_x2.stl
86.7 x 46.8 x 59.0
