Demitryk/Voron2.4-Mods/Bed_Frame_Backlit_Logo/STLs/Main_Body_x1.stl

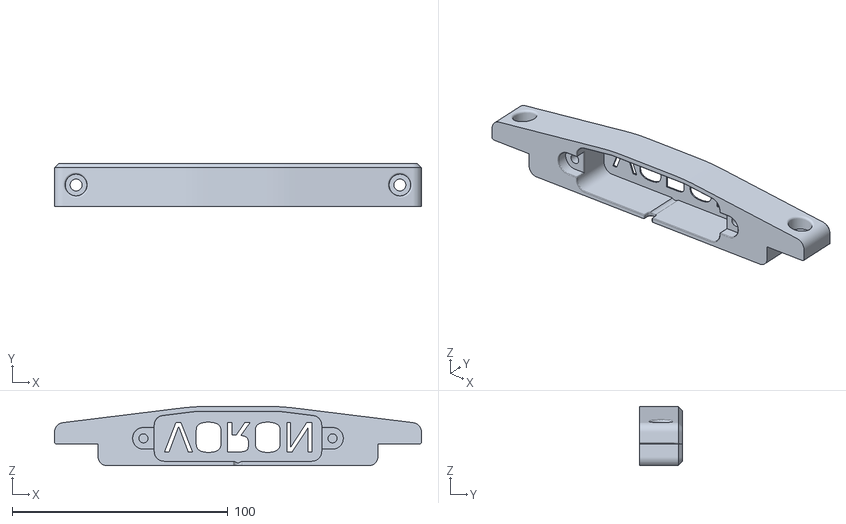
[picture p53: CAD file, 2022-04-07]
Bed_Frame_Backlit_Logo/STLs/Main_Body_x1.stl
170.0 x 20.0 x 27.4
