Demitryk/Voron2.4-Mods/Z_Belt_Cover_&_Deck_Clamps/STLs/Full_Clamp_x4.stl

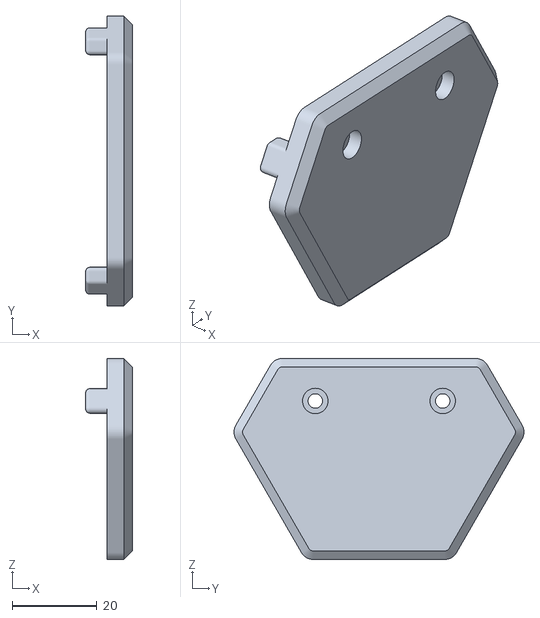
[picture p54: CAD file, 2022-01-23]
Z_Belt_Cover_&_Deck_Clamps/STLs/Full_Clamp_x4.stl
11.0 x 68.3 x 47.3
