Demitryk/Voron2.4-Mods/Backlit_Logo/STLs/Logo_Middle_x1_Clear.stl

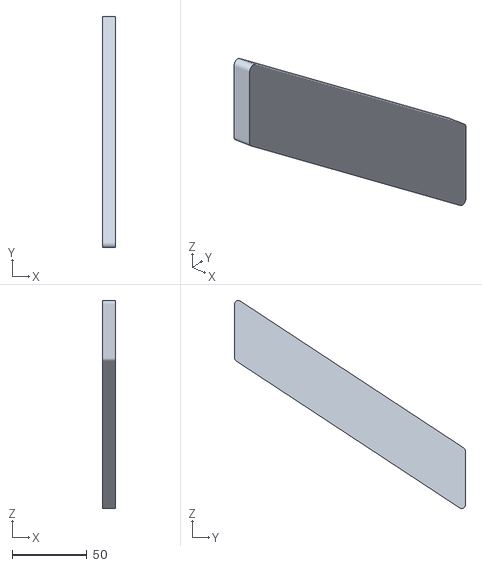
[picture p55: CAD file, 2022-01-22]
Backlit_Logo/STLs/Logo_Middle_x1_Clear.stl
8.75 x 154.7 x 139.4
