Demitryk/Voron2.4-Mods/Bed_Disconnect/STL/Bed Discconect.stl

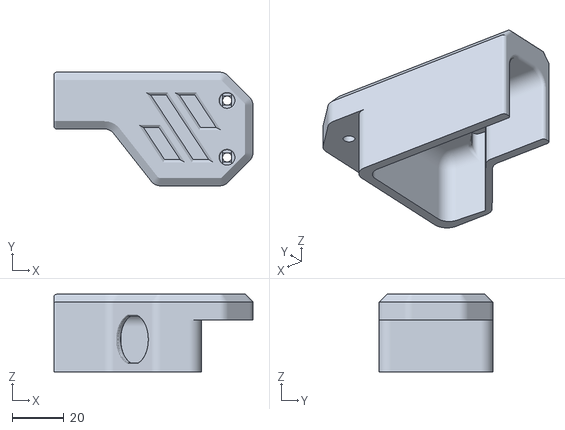
[picture p56: CAD file, 2022-03-21]
Bed_Disconnect/STL/Bed Discconect.stl
77.0 x 44.0 x 30.0
