Demitryk/Voron2.4-Mods/BTT_PiTFT5_Screen_Mount/STLs/Table Clearence  Frame Mount.stl

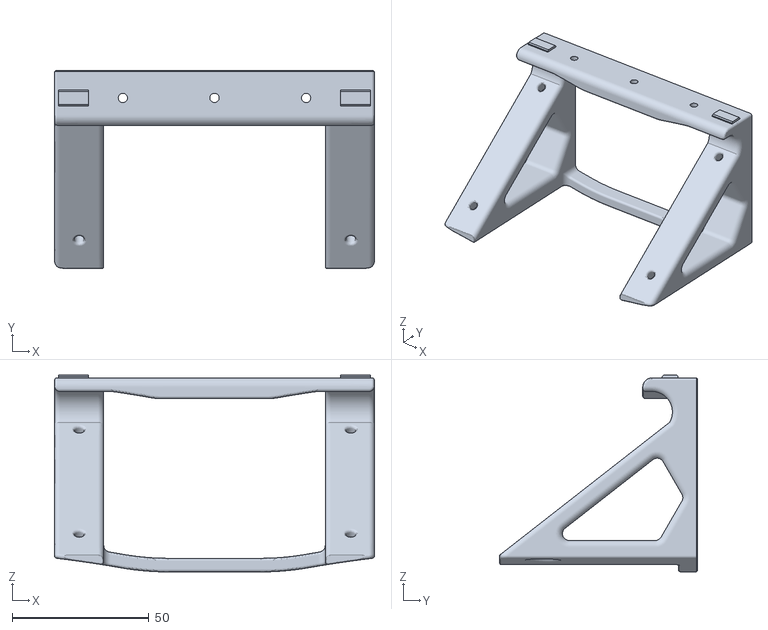
[picture p57: CAD file, 2022-01-18]
BTT_PiTFT5_Screen_Mount/STLs/Table Clearence Frame Mount.stl
117.0 x 72.3 x 72.0
