Demitryk/Voron2.4-Mods/Electronics_Brackets/STLs/Octo Pro Bracket.stl

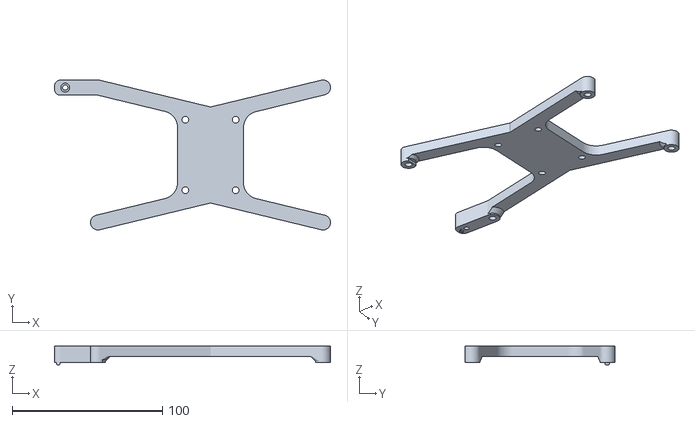
[picture p58: CAD file, 2022-02-06]
Electronics_Brackets/STLs/Octo Pro Bracket.stl
184.0 x 100.0 x 12.5
