Demitryk/Voron2.4-Mods/LGX_Adapter/STLs/LGX Adapter ERCF.stl

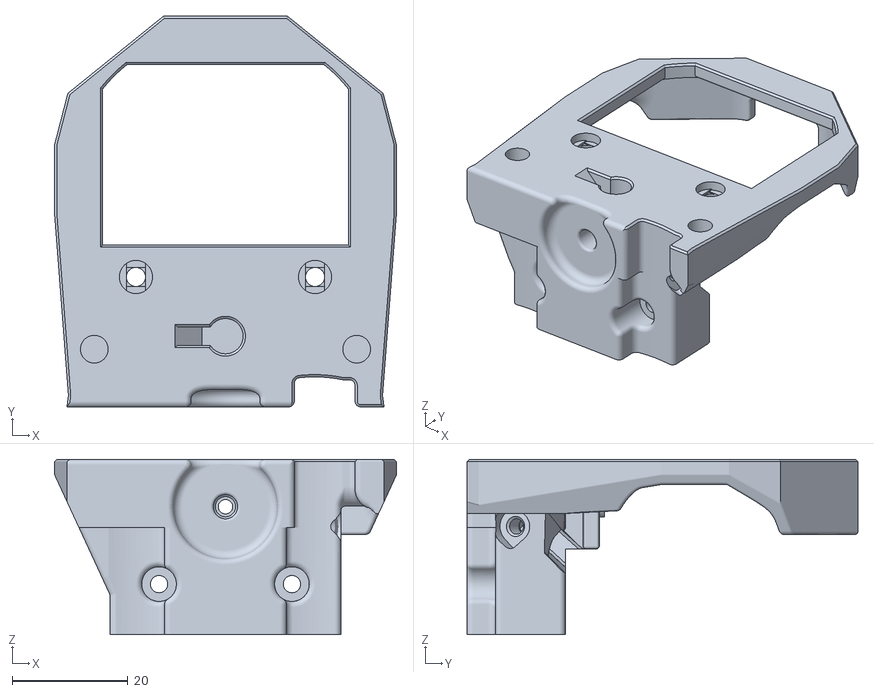
[picture p59: CAD file, 2022-02-26]
LGX_Adapter/STLs/LGX Adapter ERCF.stl
59.2 x 67.7 x 30.4
