Demitryk/Voron2.4-Mods/Skirt_Buttons/STLs/Skirt_Front_Right.stl

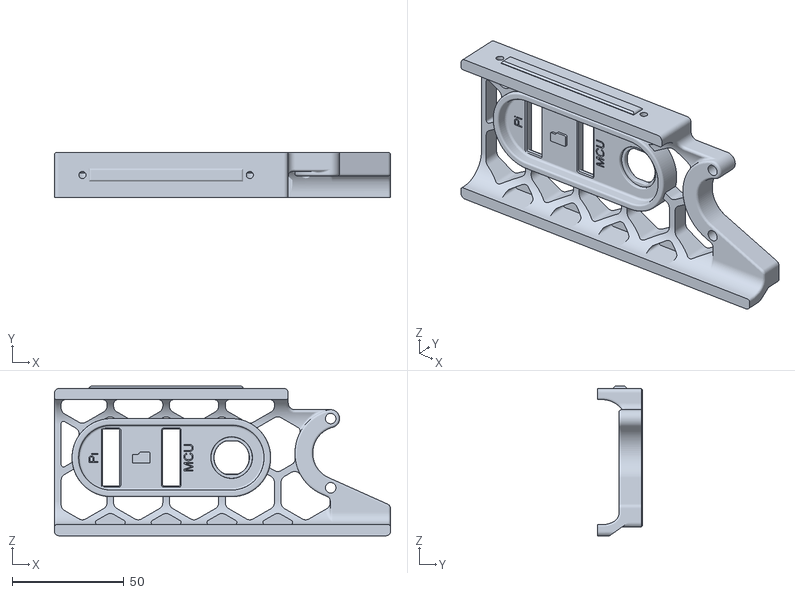
[picture p60: CAD file, 2022-01-15]
Skirt_Buttons/STLs/Skirt_Front_Right.stl
150.5 x 20.0 x 67.0
