Demitryk/Voron2.4-Mods/Talking_Voron/STLs/Speaker_Bracket.stl

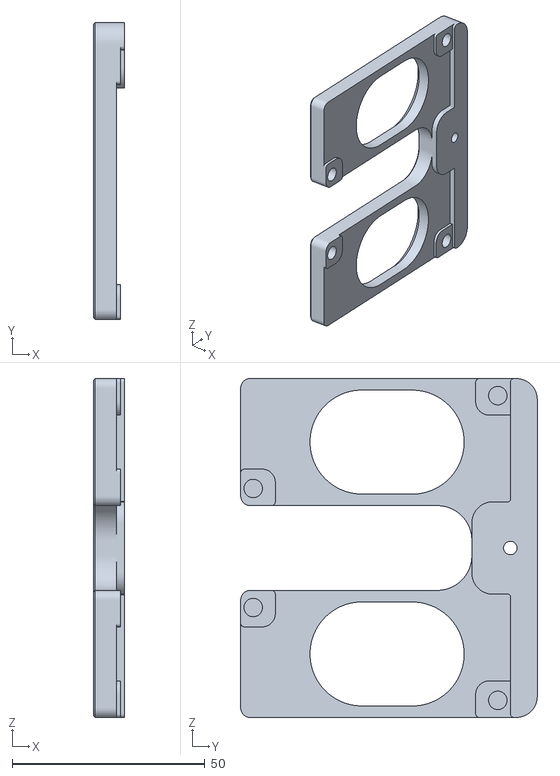
[picture p61: CAD file, 2022-03-22]
Talking_Voron/STLs/Speaker_Bracket.stl
8.00 x 77.0 x 88.0
