Demitryk/Voron2.4-Mods/Top_Filament_Guide/STLs/Top_Fil_Guide.stl

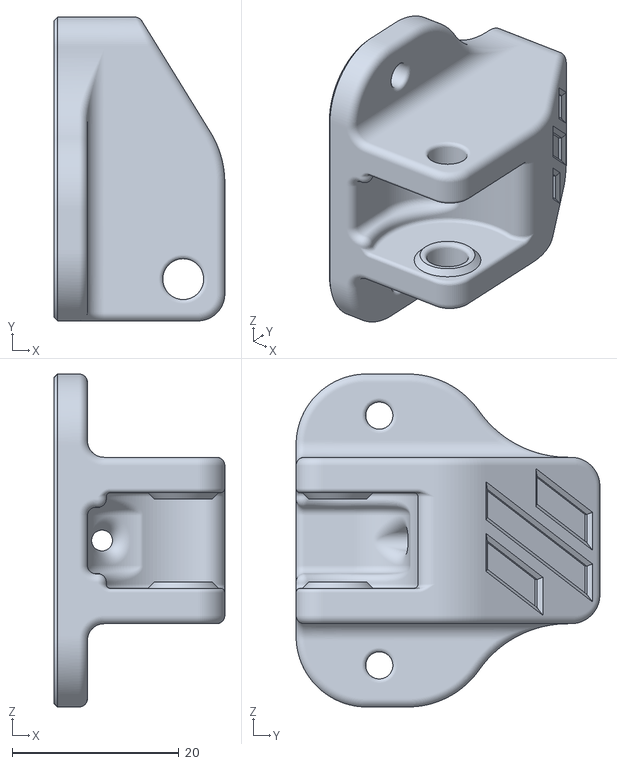
[picture p62: CAD file, 2022-04-07]
Top_Filament_Guide/STLs/Top_Fil_Guide.stl
20.5 x 36.5 x 40.0
