Demitryk/Voron2.4-Mods/4040_Feet/STLs/z_drive_retainer_b_x2.stl

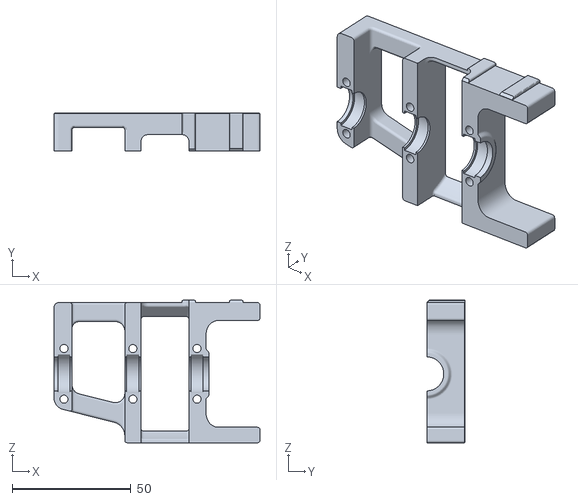
[picture p63: CAD file, 2022-01-14]
4040_Feet/STLs/z_drive_retainer_b_x2.stl
86.7 x 16.2 x 60.0
