Demitryk/Voron2.4-Mods/Backlit_Logo/STLs/Drill_Guide.stl

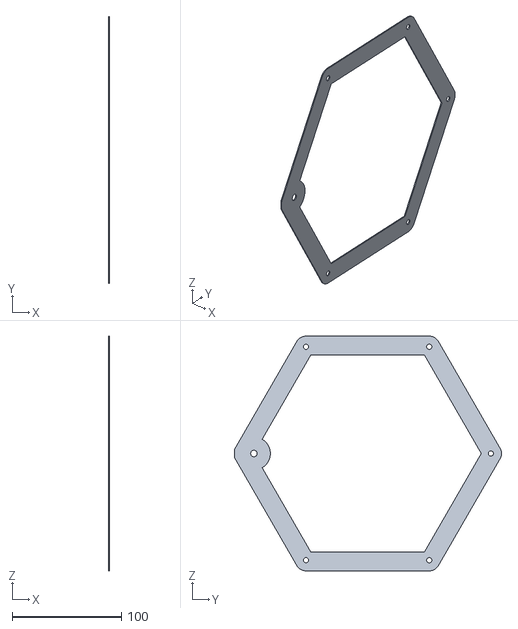
[picture p64: CAD file, 2022-01-22]
Backlit_Logo/STLs/Drill_Guide.stl
1.00 x 244.1 x 214.6
