Demitryk/Voron2.4-Mods/Bed_Frame_Backlit_Logo/STLs/O_Center_x2.stl

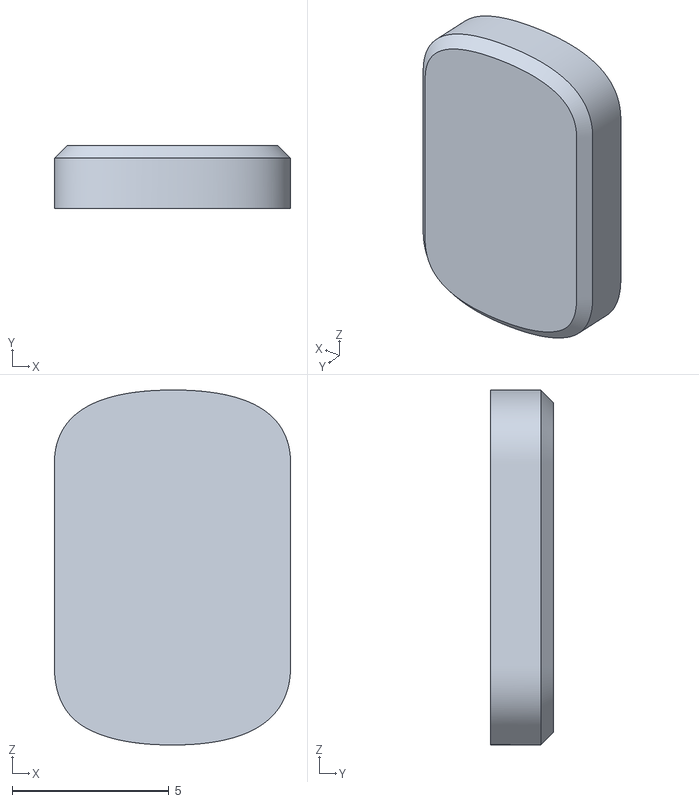
[picture p65: CAD file, 2022-04-07]
Bed_Frame_Backlit_Logo/STLs/O_Center_x2.stl
7.53 x 2.00 x 11.3
