Demitryk/Voron2.4-Mods/BTT_PiTFT5_Screen_Mount/STLs/Sttts Frame Mount (Designed by sttts).stl

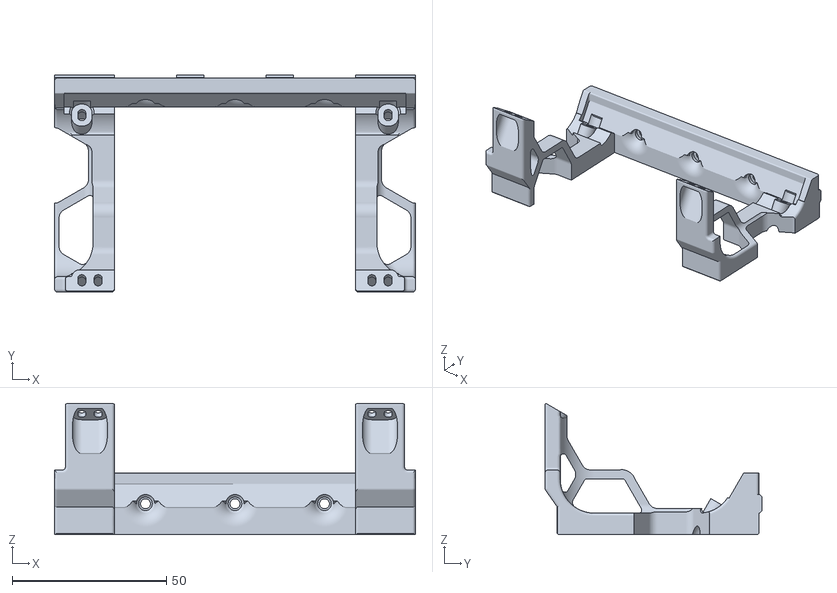
[picture p66: CAD file, 2022-01-17]
BTT_PiTFT5_Screen_Mount/STLs/Sttts Frame Mount (Designed by sttts).stl
117.0 x 70.4 x 42.6
