Demitryk/Voron2.4-Mods/Electronics_Brackets/STLs/PS Bracket 2 (24V Meanwel).stl

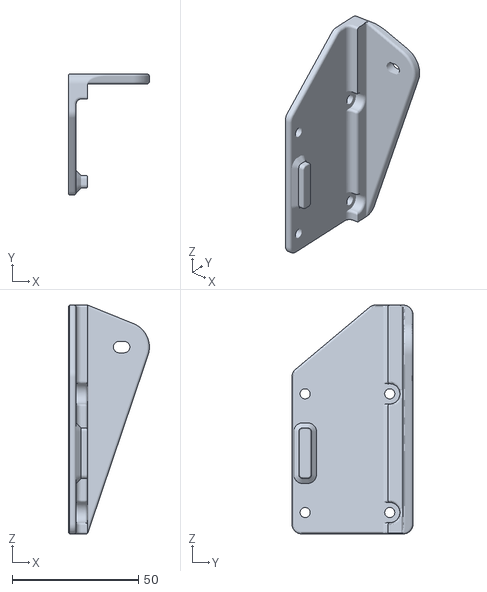
[picture p67: CAD file, 2022-02-06]
Electronics_Brackets/STLs/PS Bracket 2 (24V Meanwel).stl
32.0 x 48.0 x 90.7
