Demitryk/Voron2.4-Mods/LGX_Adapter/STLs/Connector Housing.stl

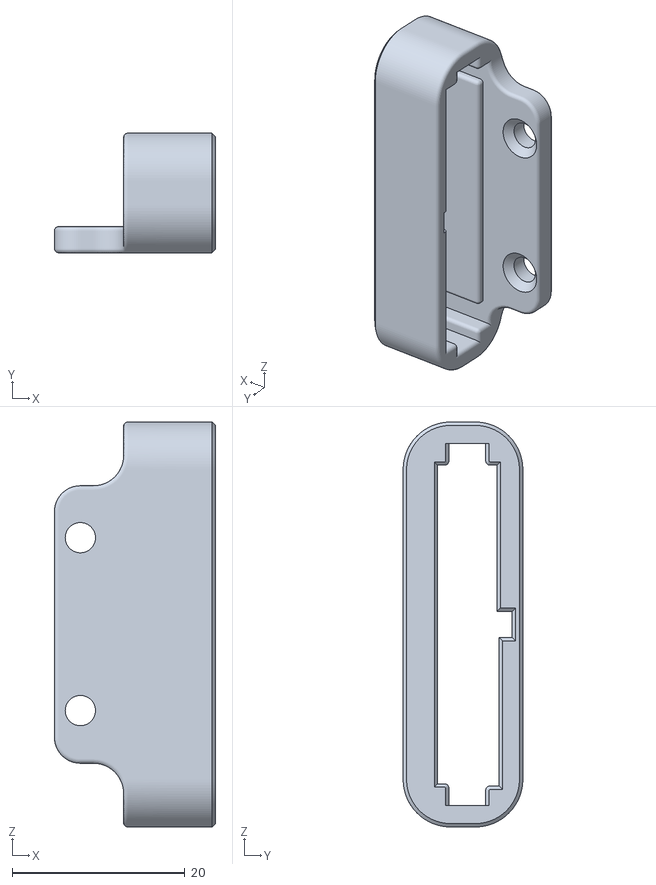
[picture p68: CAD file, 2022-02-24]
LGX_Adapter/STLs/Connector Housing.stl
18.6 x 13.8 x 46.9
