Demitryk/Voron2.4-Mods/Z_Belt_Cover_&_Deck_Clamps/STLs/Z_Belt_Cover_A_x2.stl

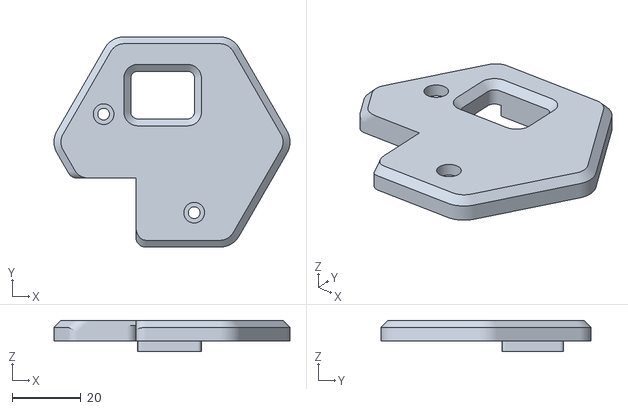
[picture p69: CAD file, 2022-01-23]
Z_Belt_Cover_&_Deck_Clamps/STLs/Z_Belt_Cover_A_x2.stl
68.4 x 61.0 x 9.00
