Demitryk/Voron2.4-Mods/Backlit_Logo/STLs/Outer_Ring_x1x_Clear.stl

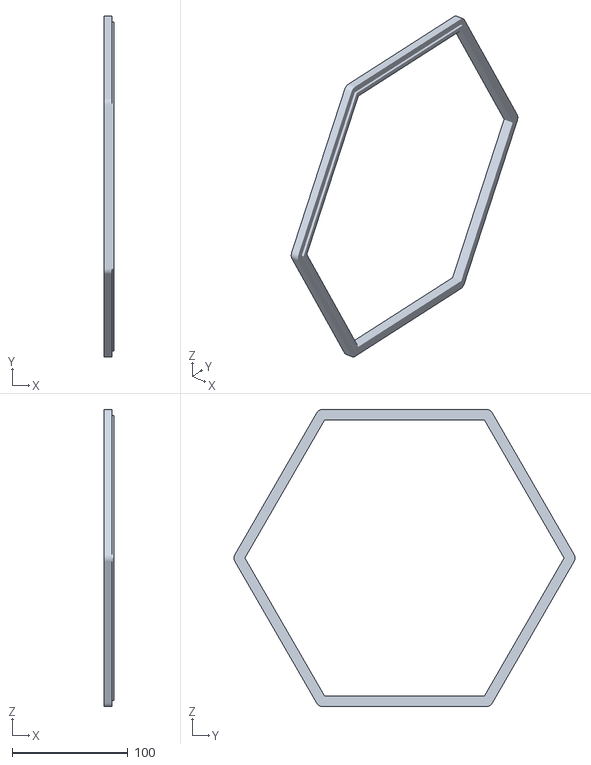
[picture p70: CAD file, 2022-01-22]
Backlit_Logo/STLs/Outer_Ring_x1x_Clear.stl
9.00 x 295.0 x 257.1
