Demitryk/Voron2.4-Mods/Bed_Frame_Backlit_Logo/STLs/Clear_Body_x1.stl

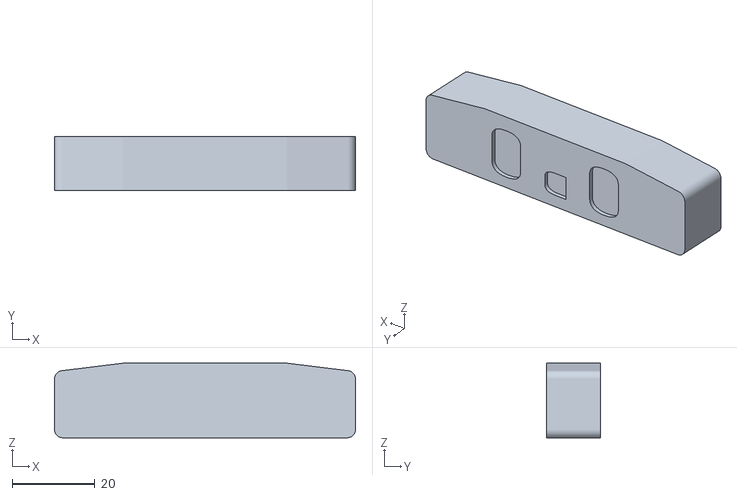
[picture p71: CAD file, 2022-04-07]
Bed_Frame_Backlit_Logo/STLs/Clear_Body_x1.stl
72.6 x 13.0 x 18.0
