Demitryk/Voron2.4-Mods/BTT_PiTFT5_Screen_Mount/STLs/Bezzel.3mf

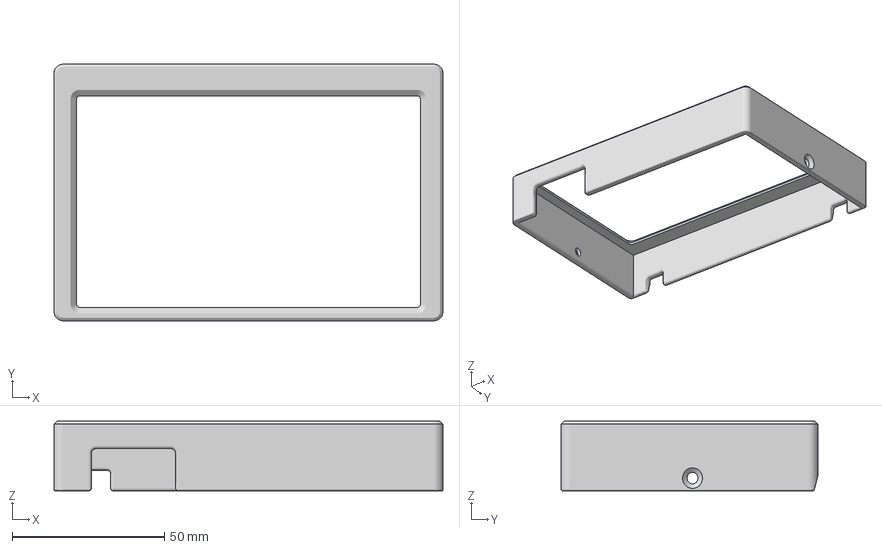
[picture p72: CAD file, 2022-01-17]
BTT_PiTFT5_Screen_Mount/STLs/Bezzel.3mf
127.9 x 84.4 x 23.0 mm
