Demitryk/Voron2.4-Mods/LGX_Adapter/STLs/Chain Anchor.stl

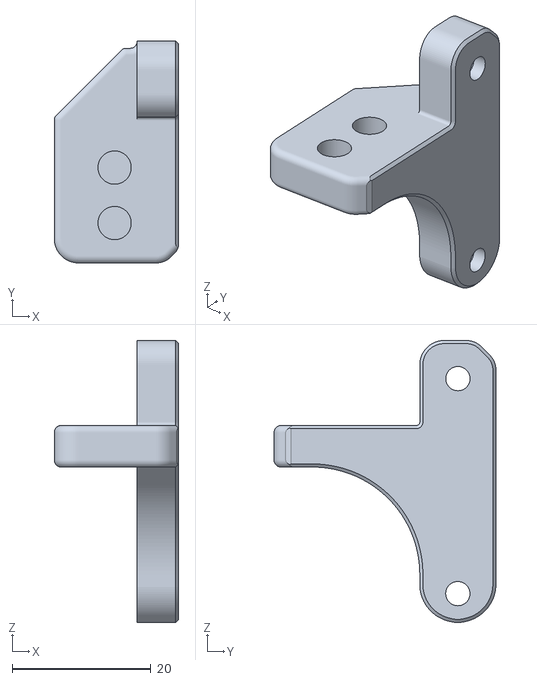
[picture p74: CAD file, 2022-02-24]
LGX_Adapter/STLs/Chain Anchor.stl
17.9 x 32.0 x 40.7
