Demitryk/Voron2.4-Mods/Skirt_Buttons/STLs/SD_Slot_x2.stl

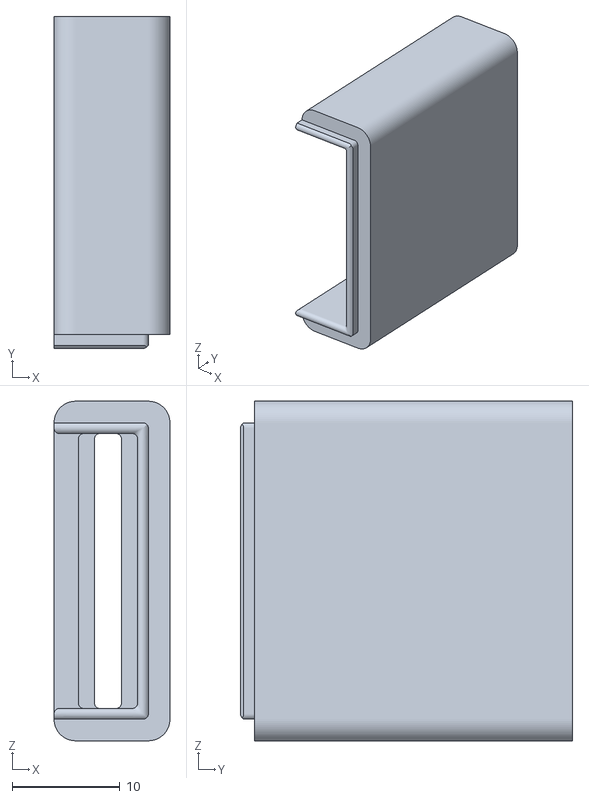
[picture p75: CAD file, 2022-01-15]
Skirt_Buttons/STLs/SD_Slot_x2.stl
10.8 x 30.8 x 31.5
