Demitryk/Voron2.4-Mods/Z_Belt_Cover_&_Deck_Clamps/STLs/Half_Clamp_B_x2.stl

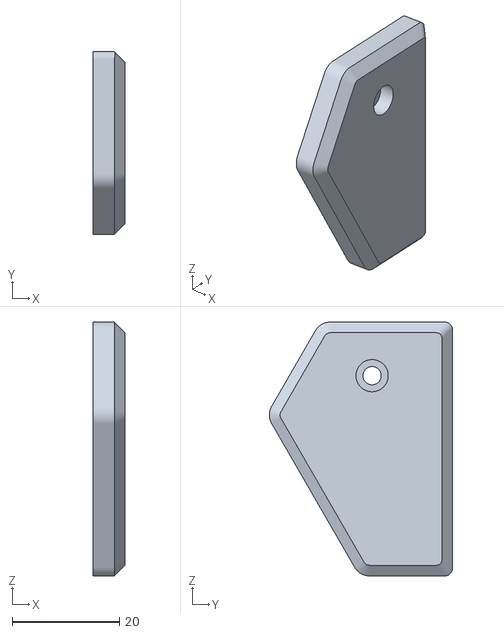
[picture p76: CAD file, 2022-01-23]
Z_Belt_Cover_&_Deck_Clamps/STLs/Half_Clamp_B_x2.stl
6.00 x 34.1 x 47.3
