Demitryk/Voron2.4-Mods/Backlit_Logo/STLs/Logo_Side_x2_Clear.stl

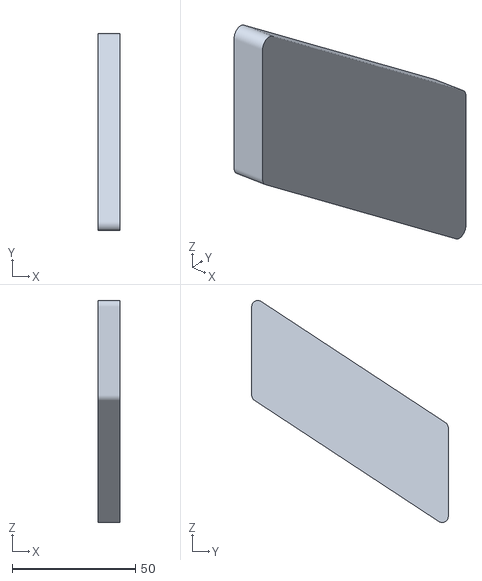
[picture p77: CAD file, 2022-01-22]
Backlit_Logo/STLs/Logo_Side_x2_Clear.stl
8.75 x 79.8 x 90.2
