Demitryk/Voron2.4-Mods/Bed_Frame_Backlit_Logo/STLs/Lid_x1.stl

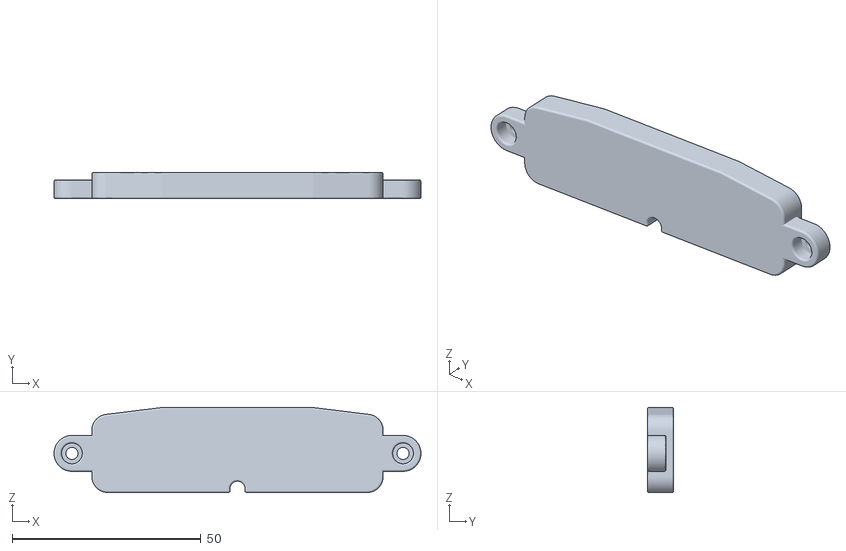
[picture p78: CAD file, 2022-04-07]
Bed_Frame_Backlit_Logo/STLs/Lid_x1.stl
97.1 x 7.00 x 22.5
