Demitryk/Voron2.4-Mods/BTT_PiTFT5_Screen_Mount/STLs/Back.3mf

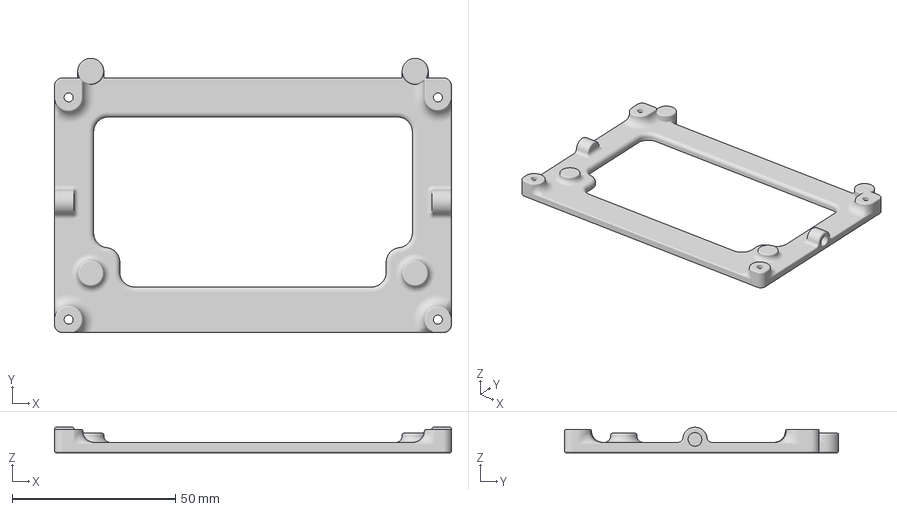
[picture p79: CAD file, 2022-01-17]
BTT_PiTFT5_Screen_Mount/STLs/Back.3mf
121.5 x 84.0 x 7.85 mm
