Demitryk/Voron2.4-Mods/Electronics_Brackets/STLs/Octo Pro Fan Shroud.stl

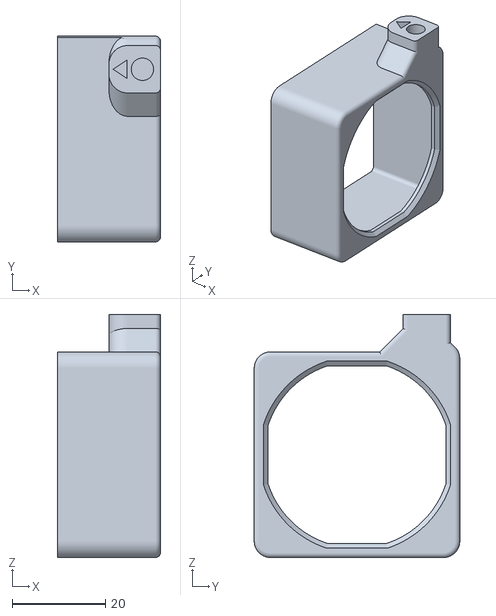
[picture p80: CAD file, 2022-02-06]
Electronics_Brackets/STLs/Octo Pro Fan Shroud.stl
22.0 x 44.0 x 52.0
