Demitryk/Voron2.4-Mods/LGX_Adapter/STLs/LGX Adapter.stl

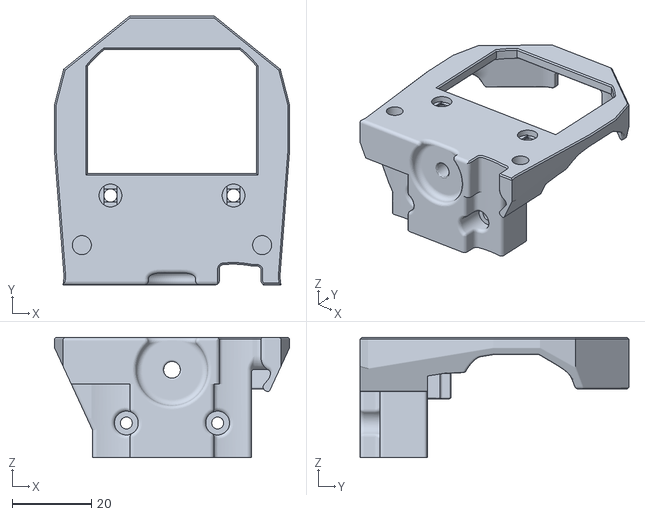
[picture p81: CAD file, 2022-01-25]
LGX_Adapter/STLs/LGX Adapter.stl
59.2 x 67.7 x 30.4
