Demitryk/Voron2.4-Mods/4040_Feet/STLs/z_motor_mount_a_x2.stl

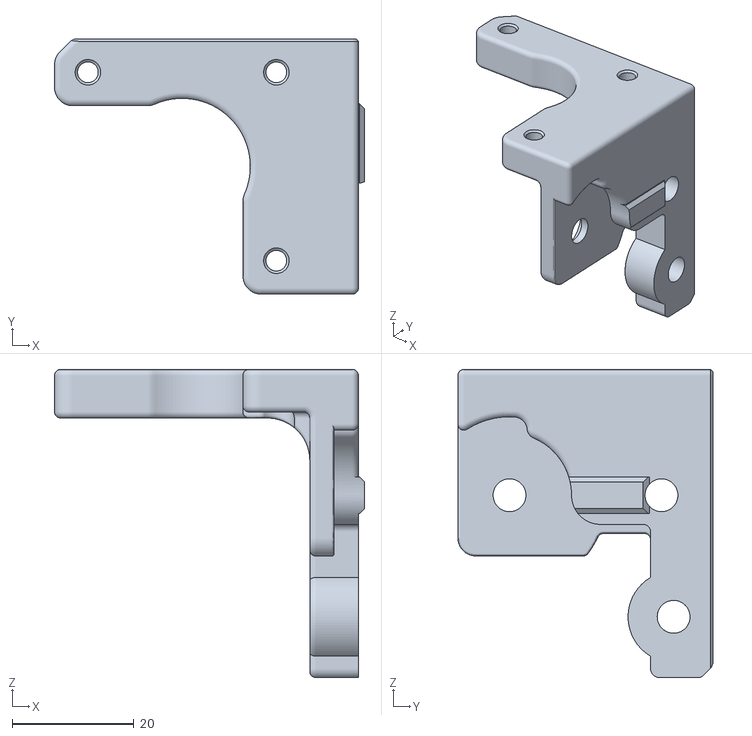
[picture p82: CAD file, 2022-01-14]
4040_Feet/STLs/z_motor_mount_a_x2.stl
51.0 x 42.0 x 50.7
