Demitryk/Voron2.4-Mods/Backlit_Logo/STLs/Logo_Frame_x1.stl

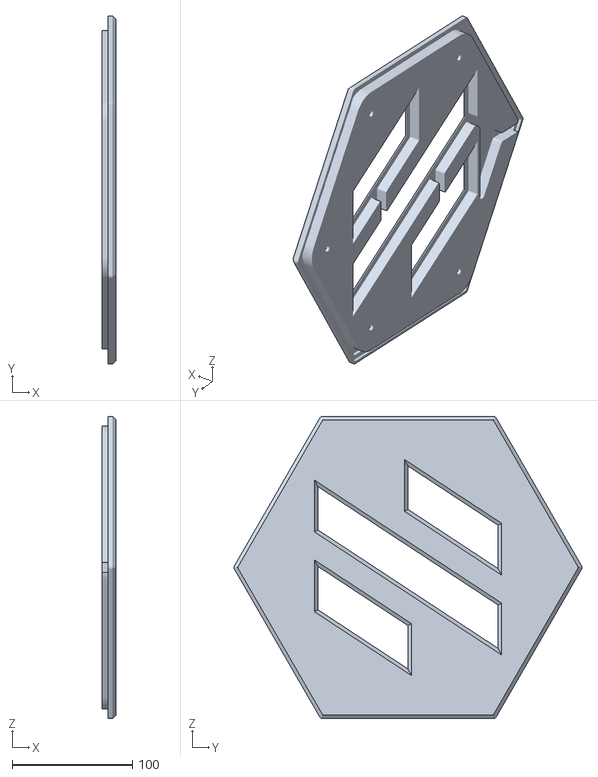
[picture p83: CAD file, 2022-01-22]
Backlit_Logo/STLs/Logo_Frame_x1.stl
12.0 x 289.1 x 251.1
