Demitryk/Voron2.4-Mods/Bed_Frame_Backlit_Logo/STLs/R_Center_x1.stl

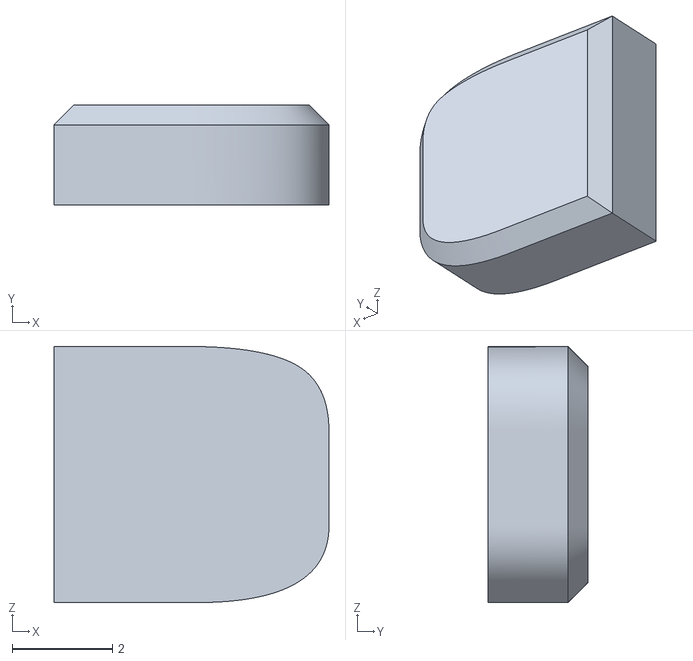
[picture p84: CAD file, 2022-04-07]
Bed_Frame_Backlit_Logo/STLs/R_Center_x1.stl
5.48 x 2.00 x 5.10
