Demitryk/Voron2.4-Mods/Electronics_Brackets/STLs/Pi Fan Shroud.stl

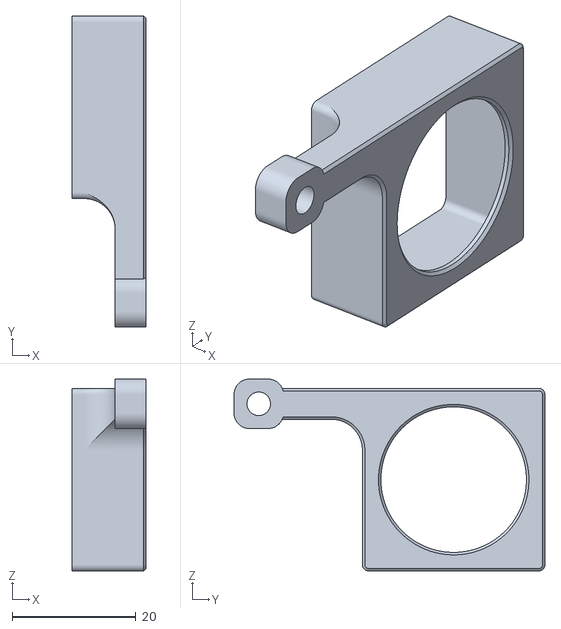
[picture p85: CAD file, 2022-02-06]
Electronics_Brackets/STLs/Pi Fan Shroud.stl
12.0 x 50.2 x 31.0
