Demitryk/Voron2.4-Mods/Electronics_Brackets/STLs/PWC Bracket.stl

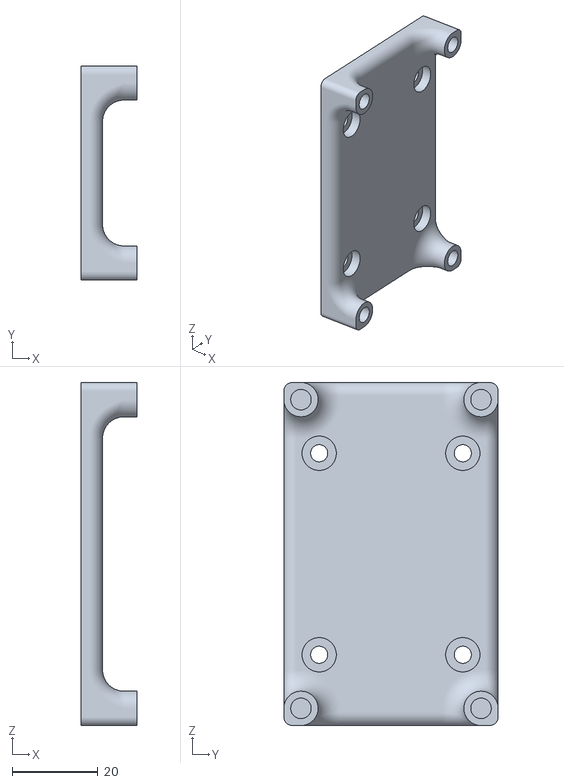
[picture p86: CAD file, 2022-02-06]
Electronics_Brackets/STLs/PWC Bracket.stl
13.0 x 50.0 x 80.0
