Demitryk/Voron2.4-Mods/Electronics_Brackets/STLs/Pi Bracket.stl

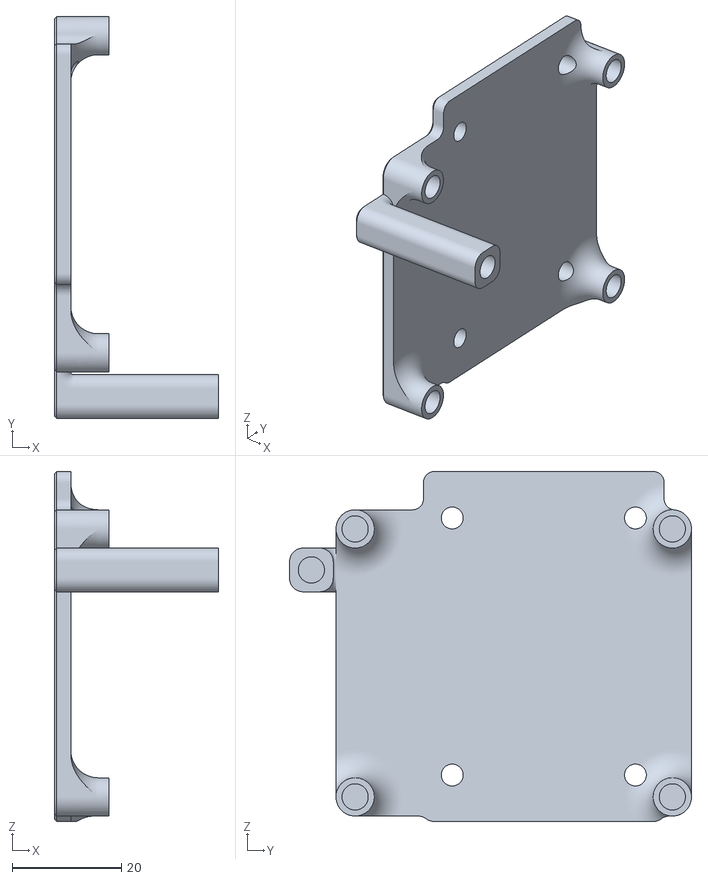
[picture p87: CAD file, 2022-02-06]
Electronics_Brackets/STLs/Pi Bracket.stl
30.0 x 73.5 x 64.0
