Demitryk/Voron2.4-Mods/(list of files, cad)

Other CAD files:
4040_Feet/STLs/z_drive_main_a_x2.stl
Skirt_Buttons/STLs/Skirt_Front_Left.stl
4040_Feet/STLs/z_drive_retainer_a_x2.stl
Z_Belt_Cover_&_Deck_Clamps/STLs/Half_Clamp_A_x2.stl
Z_Belt_Cover_&_Deck_Clamps/STLs/Z_Belt_Cover_B_x2.stl
4040_Feet/STLs/z_motor_mount_b_x2.stl
4040_Feet/CAD/4040 Voron Z Belt Drive.f3z
Backlit_Logo/CAD/Back Logo.f3z
Bed_Disconnect/CAD/Bed Disconnect.f3z
Bed_Frame_Backlit_Logo/CAD/Bed Frame Backlit Logo.f3d
Z_Belt_Cover_&_Deck_Clamps/CAD/Full Clamp.f3d
Z_Belt_Cover_&_Deck_Clamps/CAD/Half Clamp.f3d
Z_Belt_Cover_&_Deck_Clamps/CAD/Z Belt Covers.f3d
