Demitryk/Voron2.4-Mods/Top_Filament_Guide/README.md

# Top Filament Guide  #  

This is just a simple filament guide. I did not want the filament tube to go all the way to the tool head. I wanted to be able to access the filament from the tool head side just in case of a break or if I wanted to swap filament. I installed an extra extrusion across the top of my frame that this is mounted to. 
  
### Hardware Required ###  
- 2 F625Z flanged bearings  
- 1 20mm 5m screw  
- 2 m3 screws
- 2 3m t-nuts   
  
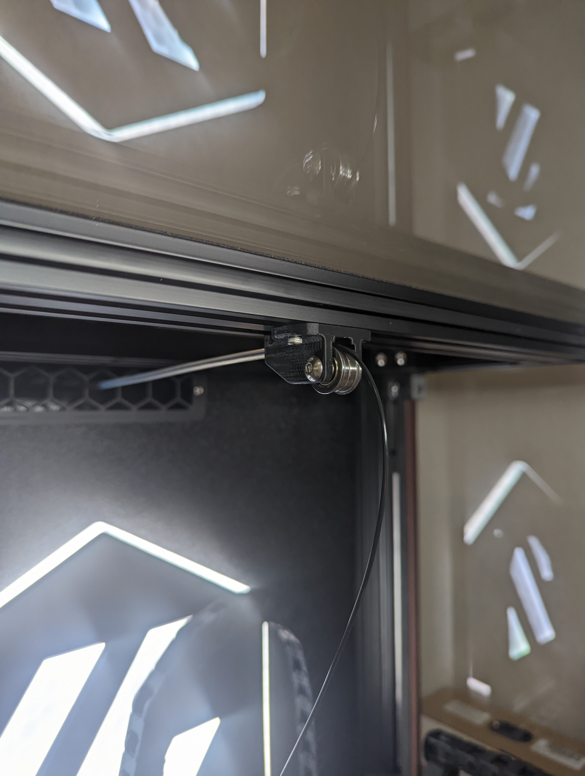
[picture p88: Top_Filament_Guide/Images/Actual.jpg]
 
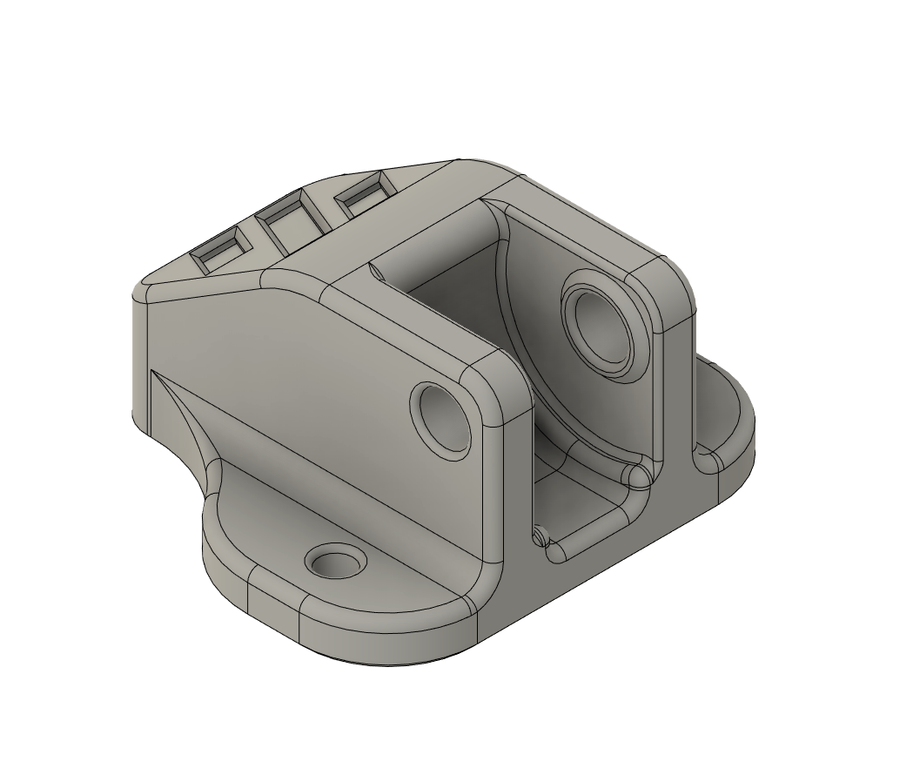
[picture p89: Top_Filament_Guide/Images/angle.PNG]
 
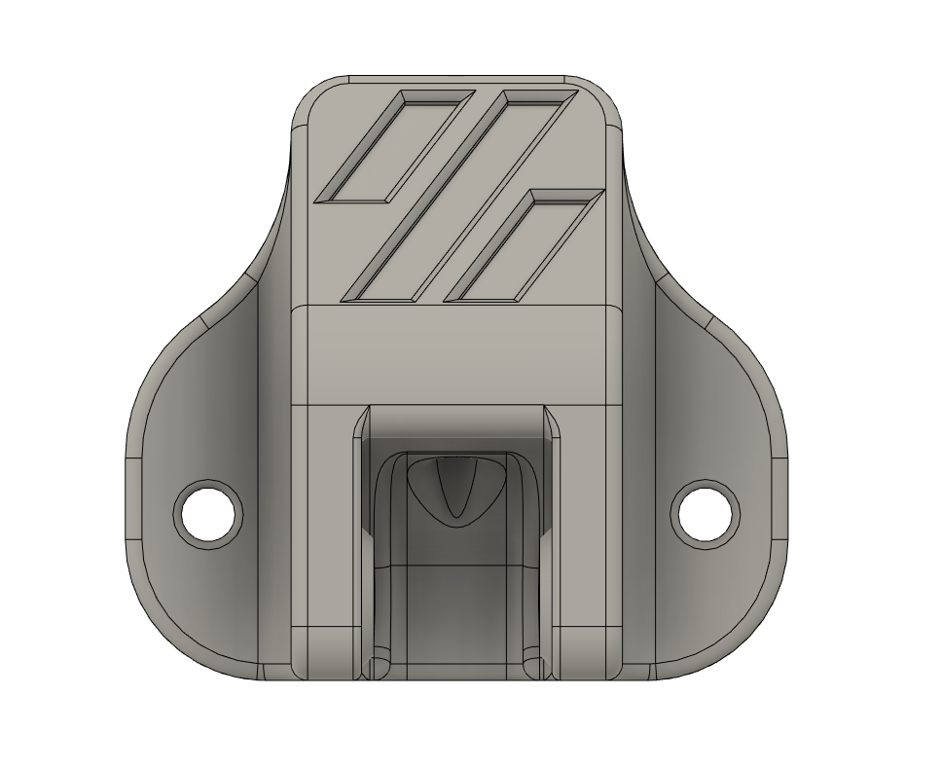
[picture p90: Top_Filament_Guide/Images/Top.PNG]
