Demitryk/Voron2.4-Mods/(commit log)

2022-01-15 Create CAD
2022-01-15 Update CAD
